minimal3dp/m3dp-changer/m3dp/bom/CxChanger_BOM_6tool.xlsx

Sheet: Summary
CxChanger build cost — Summary
Tools: 6 | Printer: Voron 2.4 350 | Sources: AliExpress + Mouser (see status column)
Section | Cost (USD)
Printhead | $68.44
Maxwell coupling & docks | $31.06
Hotend modules | $222.34
Electronics & power | $126.86
Printed parts | $0.00
Parts subtotal | $448.70
Shipping allowance | $15.00
Sales tax | $43.75
Import fees allowance | $44.87
Contingency | $46.37
ESTIMATED TOTAL | $598.69
Budget | $800.00
Remaining budget | $201.31
Per-tool cost (hotend modules ÷ tools) | $37.06
Not included
Spool holders / filament buffers for 6 separate spools.
Klipper config for T4/T5 (upstream ships T0–T3).
Dock mounting bracket design for the Voron frame (DIY. The project gives the head and basic docks only).
Klipper toolchanger plugin (free software).
Spare nozzles.

Sheet: Assumptions
CxChanger BOM — Assumptions (edit yellow cells)
Assumption | Value | Note / source
Number of tools (hotend modules) | 6 | Docks = tools. Upstream config ships T0–T3. Add T4/T5 macros + extruder4/5 sections.
Use JLC CNC plates? (Y/N) | N | N = print the plates (printed version exists). Y adds the JLCCNC line.
Est. shipping allowance (USD) | $15.00 | Assumption: most AliExpress Choice items ship free over ~$10/seller; allowance covers small-seller shipping.
Sales tax rate | 9.75% | Assumption: Clarksville/Montgomery Co., TN combined rate; AliExpress collects US sales tax at checkout. Verify.
Import fees / duty allowance | 10.00% | Assumption: US de minimis no longer covers China imports; AliExpress usually shows import charges at checkout. Adjust after cart check.
Contingency (wrong parts, re-orders) | 10.00% | Assumption.
Budget (USD) | $800.00 | From Mike's stated toolchanger budget.
How to use
1. Change the tool count in B4 — every per-tool quantity on the BOM tab updates.
2. On the BOM tab, set 'Owned?' to Y for anything you already have; its cost drops to $0.
3. Replace blue 'Est. price' values with the real cart price as you add each item on AliExpress.
4. The Summary tab totals everything against your budget.

Sheet: BOM
CxChanger BOM (v5.5 BOM + v6.11 changes) — 6 tools, Voron 2.4 350
Checked in a browser on aliexpress.us, 2026-09-30, signed out. Totals use the LIST (strikethrough) price, so they are an upper bound. AliExpress showed $1.09 new-shopper deals on most items; your signed-in cart price will likely be lower. Blue = inputs.
# | Section | Part | Spec | Qty needed | Pack size | Packs to buy | List price / pack (USD) | Owned? (Y/N) | Line cost (USD) | Link | Notes | Verification status (2026-09-30) | Promo price shown (new-shopper, signed out)
1 | Printhead | HGX gear set (gears only) | Variant: '1 Set HGX Gear' (17/44 double gear + 36T drive gears) | 1 | 1 | 1 | $6.95 | N | $6.95 | https://www.aliexpress.us/item/3256808936360634.html | MEGA 3D Printer Store, 800+ sold, free shipping. The old link (3256807033585974) was a full extruder with motor ($21.21, $46 express shipping), so it was replaced. | Browser-verified item + variant | $1.09
2 | Printhead | Bearing MR63ZZ 3×6×2.5 mm | 10 pcs/lot | 4 | 10 | 1 | $4.01 | N | $4.01 | https://www.aliexpress.us/item/3256801934742685.html | Homeclub Store, 1,000+ sold. | Browser-verified item | $1.09
3 | Printhead | Dowel pin Ø3 × 16 mm | GB119 listing; pick M3 × 16 | 2 | 20 | 1 | $1.90 | N | $1.90 | https://www.aliexpress.us/item/3256806837028480.html | 304 stainless (not hardened). Variant price not checked. 5,000+ sold. | Browser-verified listing; variant not priced | $1.09
4 | Printhead | Dowel pin Ø3 × 24 mm | GB119 listing; pick M3 × 24 | 1 | 20 | 1 | $1.90 | N | $1.90 | https://www.aliexpress.us/item/3256806837028480.html | Same listing as above. | Browser-verified listing; variant not priced | $1.09
5 | Printhead | Compression spring assortment | Small springs for idler | 1 | 1 | 1 | $3.00 | N | $3.00 | https://www.aliexpress.us/w/wholesale-compression-spring-assortment.html | No listing checked. | Estimate – search link
6 | Printhead | NEMA14 36 mm pancake stepper (HGX-LITE pinion) | 'for HGX-LITE dual gear, 10 teeth reduction gear' | 1 | 1 | 1 | $8.85 | N | $8.85 | https://www.aliexpress.us/item/3256808807952066.html | Pinion must mesh with the HGX 17/44 gear. This listing is sold for HGX-LITE. Alternative: Mellow LDO 36STH20 (item 3256802713546002, $21.37 list / $8.62 shown), but check its pinion. Check your Galileo 2 spare motor first. | Search-page price (item not opened) | $1.09
7 | Printhead | 2510 axial fan 24 V (hotend/throat) | Variant: 24V, hydraulic bearing | 1 | 1 | 1 | $0.87 | N | $0.87 | https://www.aliexpress.us/item/2251832624516972.html | LINK CNC Official Store, 3,000+ sold. | Browser-verified item + variant
8 | Printhead | 4020 blower fan 24 V | Variant: 4020 24V, XH2.54 plug | 1 | 1 | 1 | $3.27 | N | $3.27 | https://www.aliexpress.us/item/2251832787493408.html | IdeaFormer Official Store, 2,000+ sold, free shipping. | Browser-verified item + variant | $1.09
9 | Printhead | Omron D2F-01F micro switch | Variant: D2F-01F, 1 pc | 2 | 1 | 2 | $0.84 | N | $1.68 | https://www.aliexpress.us/item/3256805018062207.html | Qty 2: Z probe + v6.11 tool/filament sensor. Listed 'authentic original'. 5,000+ sold. | Browser-verified item + variant
10 | Printhead | M4 hex standoffs | Pick M4 × 10 (2) and M4 × 14 (1), female-female | 1 | 1 | 1 | $7.58 | N | $7.58 | https://www.aliexpress.us/item/3256808527324482.html | Listing price, variant not checked. | Browser-verified listing; variant not priced | $1.09
11 | Printhead | M4 hollow (through-hole) socket-head bolt | Pick M4, short length | 1 | 1 | 1 | $1.62 | N | $1.62 | https://www.aliexpress.us/item/3256807635919515.html | Original BOM: '带孔螺栓'. | Browser-verified listing; variant not priced | $1.09
12 | Printhead | Metric screw assortment M2 / M2.5 / M3 | SHCS + nuts | 1 | 1 | 1 | $10.00 | N | $10.00 | https://www.aliexpress.us/w/wholesale-m2-m2.5-m3-socket-head-screw-kit.html | No listing checked. Set Owned = Y if you have one. | Estimate – search link
13 | Printhead | M3 × 22 button-head, black 10.9 | Variant: M3 (50pcs), 22mm | 7 | 50 | 1 | $2.44 | N | $2.44 | https://www.aliexpress.us/item/2251832782727837.html | HZYUEGOU. | Browser-verified item + variant | $1.09
14 | Printhead | M3 heat-set inserts | Variant: 100 PCS M3X4X5 | 20 | 100 | 1 | $10.37 | N | $10.37 | https://www.aliexpress.us/item/3256810138806595.html | Check the size against the CAD holes (project lists M3 × 4 × 4). | Browser-verified item + variant | $1.09
15 | Printhead | Self-adhesive high-temp silicone strip 10 × 2 mm | Plugs parked nozzles in the docks | 1 | 1 | 1 | $4.00 | N | $4.00 | https://www.aliexpress.us/w/wholesale-silicone-strip-10x2mm-adhesive.html | No good AliExpress match found (results were door weather-strip). Consider a silicone sheet instead. | Not found – estimate
16 | Printhead | JLC CNC plates (5 parts) | Top magnet plate, spring plate, swing arms ×2, back plate | 0 | 1 | 0 | $22.00 | N | $0.00 | https://jlccnc.com | Not on AliExpress. Controlled by Assumptions B5. | Other vendor – estimate
17 | Maxwell coupling & docks | Dowel pin Ø1.5 × 5 mm | GB119 listing; pick M1.5 × 5 | 6 | 50 | 1 | $1.90 | N | $1.90 | https://www.aliexpress.us/item/3256806837028480.html | Variant price not checked. | Browser-verified listing; variant not priced | $1.09
18 | Maxwell coupling & docks | Round-head pin Ø3 × 4 mm | 3 per hotend | 18 | 20 | 1 | $3.00 | N | $3.00 | https://www.aliexpress.us/w/wholesale-round-head-pin-3mm.html | No match found on AliExpress in 3 searches. Chinese BOM links Tmall item 868817943817. Size 3×4 vs 3×6: check the CAD. | Not found – estimate
19 | Maxwell coupling & docks | Female-threaded round-head pin M3, Ø5 × 20 mm | 1 per dock | 6 | 10 | 1 | $4.00 | N | $4.00 | https://www.aliexpress.us/w/wholesale-m3-internal-thread-round-head-pin-5mm.html | No match found on AliExpress. Chinese BOM links Tmall item 864132087543. | Not found – estimate
20 | Maxwell coupling & docks | N52 magnet Ø6 × 4 mm | Variant: 6x4mm N52, 50pcs | 27 | 50 | 1 | $12.94 | N | $12.94 | https://www.aliexpress.us/item/3256809533301082.html | Magnet Customised Factory Store, 1,000+ sold. 30pcs is $9.65 and 100pcs is $18.49. | Browser-verified item + variant | $1.09
21 | Maxwell coupling & docks | M3 black grade 12.9 socket-head screw (hook) | DIN912; length per CAD | 6 | 50 | 1 | $1.50 | N | $1.50 | https://www.aliexpress.us/item/3256805693063078.html | Listing shows ~$0.02/pc. Must be 12.9 alloy steel so the magnets hold it. | Search-page price (item not opened) | $1.09
22 | Maxwell coupling & docks | Dock cooling fan 2510 24 V, 1 per dock | Same LINK CNC listing, 24V | 6 | 1 | 6 | $0.87 | N | $5.22 | https://www.aliexpress.us/item/2251832624516972.html | Size assumed; verify in the 6.11 dock STEP. | Browser-verified item + variant
23 | Maxwell coupling & docks | M3 roll-in spring T-nuts (2020) | 2 per dock; 50 pcs | 12 | 50 | 1 | $2.50 | N | $2.50 | https://www.aliexpress.us/item/2251832837457300.html | Listing shows ~$0.05/pc. | Search-page price (item not opened) | $1.09
24 | Hotend modules | TZ 2.0 hotend (Bambu X1/P1 style) – Mellow | Variant: 'TZ2 Hotend' | 6 | 1 | 6 | $19.98 | N | $119.88 | https://www.aliexpress.us/item/3256805875155396.html | Mellow 3D Official Store (only 28 sold). The Trianglelab link from the last BOM (1005005920817062) now returns 'page not found' on aliexpress.us. Alternative: YUNSN TZ2.0 kit with 60W heater, item 3256808914626535, 'Hotend for X1' $42.15 list / $33.72 sale. Check whether the Mellow hotend includes a heater. | Browser-verified item + variant | $1.09
25 | Hotend modules | Ceramic heater 24 V 48 W + NTC 100K 3950 | Pick 48W (not 60W/82W) | 6 | 1 | 6 | $3.40 | N | $20.40 | https://www.aliexpress.us/item/3256808485891466.html | Use 48 W: 6 × 82 W = 492 W would overload the 350 W PSU during simultaneous preheat. Set sensor_type to Generic 3950. Upstream uses ATC Semitec 104GT-2. | Search-page price (item not opened) | $2.72
26 | Hotend modules | Silicone sock, Bambu X1/P1 | Variant: For BambuLab X1 P1, 1pcs | 6 | 1 | 6 | $1.79 | N | $10.74 | https://www.aliexpress.us/item/3256808316755061.html | Multi-packs (3/5/10) are available; buying 10 is likely cheaper. | Browser-verified item + variant | $1.09
27 | Hotend modules | Flexible towline cable 4-core 22 AWG | Heater + thermistor, per metre | 9 | 1 | 9 | $3.03 | N | $27.27 | https://www.aliexpress.us/item/2255800968230040.html | Qty in metres. Pick 4-core 22 AWG. Price shown for the default variant. | Search-page price (item not opened) | $2.33
28 | Hotend modules | Molex Micro-Fit 3.0 housings + terminals | 10 sets, 2-pin | 12 | 10 | 2 | $2.03 | N | $4.06 | https://www.aliexpress.us/item/3256802961371687.html | 2 connectors per tool (heater + thermistor). | Search-page price (item not opened) | $1.93
29 | Hotend modules | Capricorn PTFE 1 m (head liner) | Variant: 1M PTFE | 1 | 1 | 1 | $7.69 | N | $7.69 | https://www.aliexpress.us/item/3256804674205585.html | Creality Capricorn. Only the head path needs Capricorn. | Browser-verified item + variant | $1.09
30 | Hotend modules | Generic PTFE 2 × 4 mm (tool feed tubes) | ~1.5 m per tool | 9 | 5 | 2 | $6.00 | N | $12.00 | https://www.aliexpress.us/w/wholesale-ptfe-tube-2x4mm-5m.html | Qty in metres. No listing checked. | Estimate – search link
31 | Hotend modules | PC4-M6 push fittings | Variant: PC4-M6-10pcs | 12 | 10 | 2 | $10.15 | N | $20.30 | https://www.aliexpress.us/item/3256809971210588.html |  | Browser-verified item + variant | $1.09
32 | Electronics & power | Mainboard heater/thermistor ports (T0–T3) | BTT Manta M8P: HE0–HE3 + TH0–TH3 | 1 | 1 | 1 | $0.00 | Y | $0.00 |  | Owned. Covers 4 of 6 tools. | —
33 | Electronics & power | BTT EBB36 CAN V1.2 (T4–T5) | Variant: 'EBB 36' (no MAX31865) | 2 | 1 | 2 | $36.37 | N | $72.74 | https://www.aliexpress.us/item/3256807670809484.html | AliExpress list $36.37 (vs $19.99 at biqu.equipment). Your 2 spare EBB SB2209s do the same job: set Owned = Y. | Browser-verified item + variant | $4.41
34 | Electronics & power | CAN cable (twisted pair + 24 V) | ~2 m | 1 | 1 | 1 | $6.00 | N | $6.00 | https://www.aliexpress.us/w/wholesale-can-bus-cable-4-core-twisted.html | No good AliExpress match found. | Not found – estimate
35 | Electronics & power | Mean Well LRS-350-24 (24 V 14.6 A, 350 W) | Dedicated hotend PSU | 1 | 1 | 1 | $32.10 | N | $32.10 | https://www.mouser.com/ProductDetail/MEAN-WELL/LRS-350-24?qs=ah3jBNVE1PT%2BkwLcackrGA%3D%3D | Mouser $32.10 (TRC $34.81). From an authorized distributor, not AliExpress. | Authorized distributor – price verified
36 | Electronics & power | Ferrule crimper + ferrule kit | For PSU AC/DC wiring | 1 | 1 | 1 | $16.02 | N | $16.02 | https://www.aliexpress.us/item/3256809851025256.html | Skip if you have a crimper. Common DC − between the PSUs; earth both chassis. | Search-page price (item not opened) | $1.09
37 | Electronics & power | Nozzle offset calibration probe | BTT Eddy (owned) or ball probe | 1 | 1 | 1 | $0.00 | Y | $0.00 |  | Owned. | —
38 | Printed parts | Printed parts filament (ABS/ASA) | ~0.6 kg | 1 | 1 | 1 | $15.00 | Y | $0.00 | https://www.aliexpress.us/w/wholesale-asa-filament-1kg.html | Assumed owned. | —
 |  |  |  |  |  |  |  | Total | $448.70

Sheet: Sources
Sources
CxChanger original repo + 5.5 BOM (quantities, ¥ prices) | https://github.com/cx330-TXY/CxChanger
CxChanger English translation (parts list, pin sizes) | https://github.com/WheelsTheCat/CxChanger
Trianglelab TZ-V6-2.0 hotend list price ($27) | https://www.trianglelab.net/products/tz-v6-20-hotend
AliExpress TZ 2.0 hotend listing | https://www.aliexpress.com/item/1005005920817062.html
AliExpress ceramic heater + thermistor listing | https://www.aliexpress.us/item/3256807569217043.html
AliExpress 36 mm pancake stepper listing | https://www.aliexpress.us/item/3256804107613674.html
AliExpress HGX gear set listing | https://www.aliexpress.us/item/3256807033585974.html
Mouser LRS-350-24 ($32.10, verified 2026-09-30) | https://www.mouser.com/ProductDetail/MEAN-WELL/LRS-350-24?qs=ah3jBNVE1PT%2BkwLcackrGA%3D%3D
TRC Electronics LRS-350-24 ($34.81) | https://www.trcelectronics.com/products/mean-well-lrs-350-24
Trianglelab TZ 2.0 for Bambu ($45.99) | https://trianglelab.net/products/tz-20-hotend-for-bambu-lab-x1-p1p
BIQU EBB36/42 (from $19.99) | https://biqu.equipment/products/bigtreetech-ebb36-42-can-bus-u2c-v2-1-klipper-board
AliExpress EBB36 CAN V1.2 listing | https://www.aliexpress.us/item/3256804056891440.html
Upstream v6.11 changes (2026-09-29): new printhead 6.11 zip, dock 6.11 STEP, tool-change-failure + runout sensor | https://github.com/cx330-TXY/CxChanger/commits/main
Note: AliExpress blocks automated reads. AliExpress prices are estimates; verify in cart.
