minimal3dp/m3dp-changer/m3dp/cad/printed-6.11/voron-integration/tap/tap-adapter-top-fan-carrier-PROTOTYPE-assembly.stl

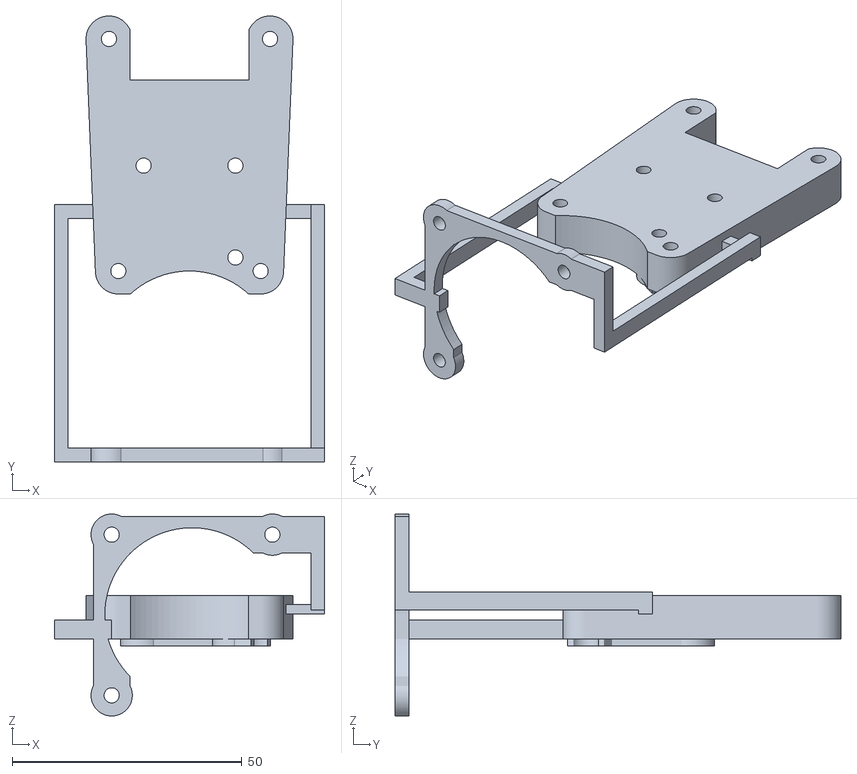
[picture p2: CAD file, 2026-11-01]
m3dp/cad/printed-6.11/voron-integration/tap/tap-adapter-top-fan-carrier-PROTOTYPE-assembly.stl
58.9 x 97.1 x 44.0
