minimal3dp/m3dp-changer/m3dp/cad/printed-6.11/p1-magnet-plate-integral-pillars-assembly.stl

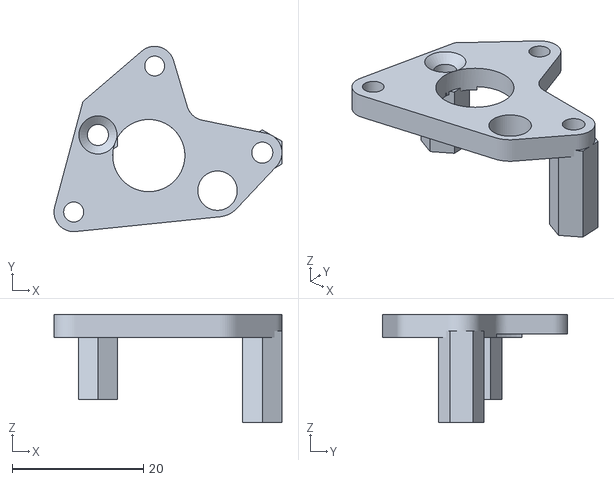
[picture p3: CAD file, 2026-11-01]
m3dp/cad/printed-6.11/p1-magnet-plate-integral-pillars-assembly.stl
34.8 x 28.2 x 16.5
