minimal3dp/m3dp-changer/m3dp/cad/printed-6.11/voron-integration/tap/tap-top-fan-duct-PROTOTYPE-assembly.stl

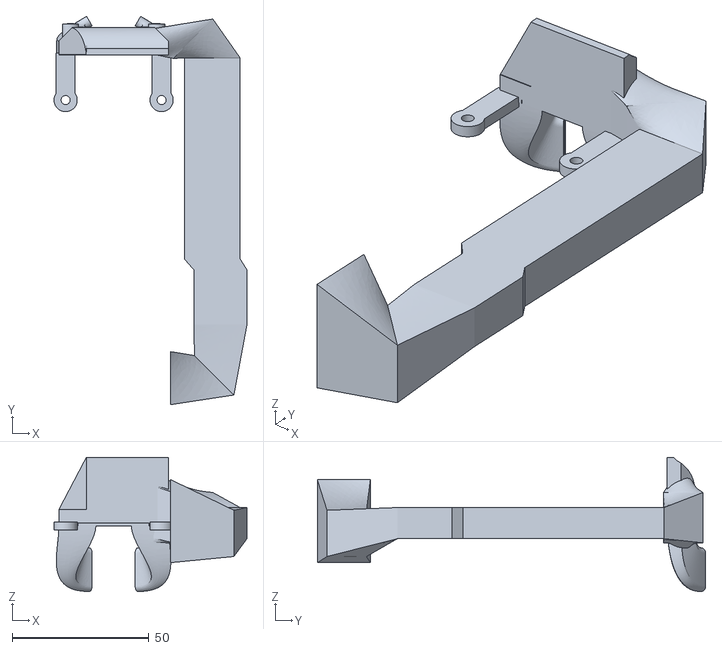
[picture p4: CAD file, 2026-11-01]
m3dp/cad/printed-6.11/voron-integration/tap/tap-top-fan-duct-PROTOTYPE-assembly.stl
70.5 x 142.0 x 49.0
