minimal3dp/m3dp-changer/m3dp/cad/printed-6.11/p3-cover-left-clamp-web-assembly.stl

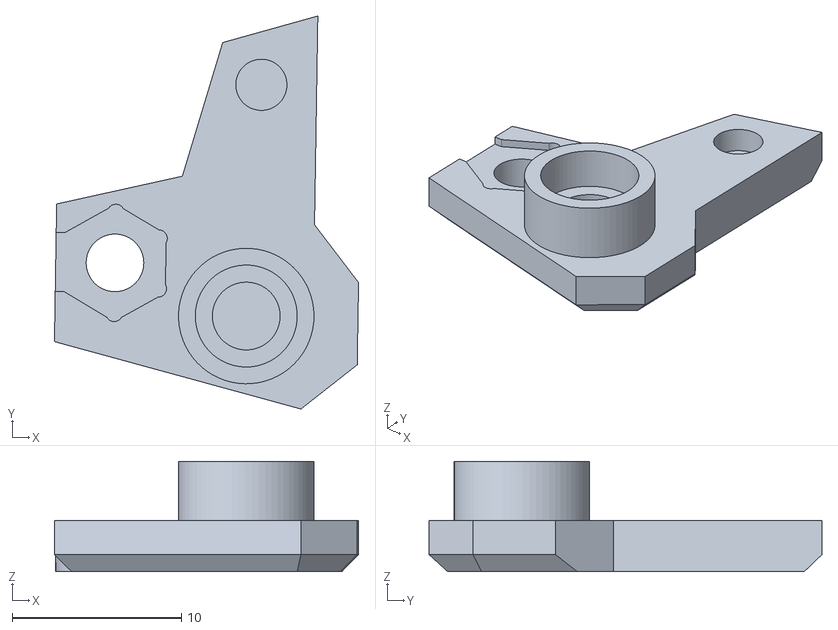
[picture p5: CAD file, 2026-11-01]
m3dp/cad/printed-6.11/p3-cover-left-clamp-web-assembly.stl
18.0 x 23.2 x 6.50
