minimal3dp/m3dp-changer/m3dp/cad/printed-6.11/p4-cover-right-clamp-web-assembly.stl

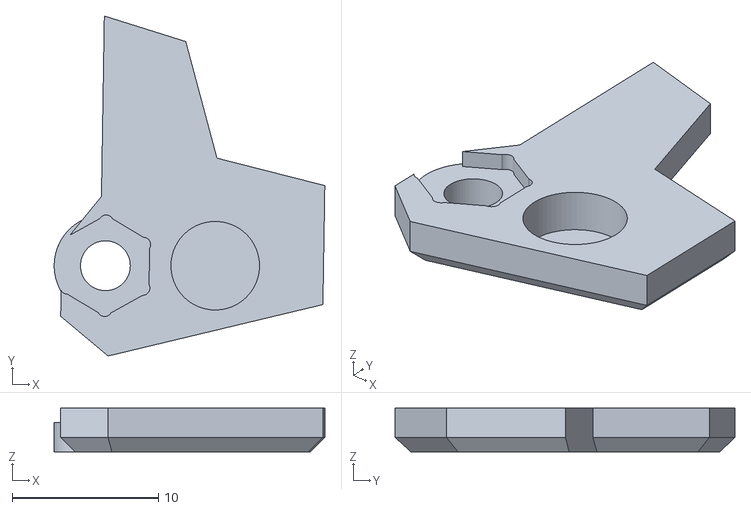
[picture p6: CAD file, 2026-11-01]
m3dp/cad/printed-6.11/p4-cover-right-clamp-web-assembly.stl
18.5 x 23.2 x 3.00
