minimal3dp/m3dp-changer/m3dp/cad/m3dp_cnc_6_p7.step

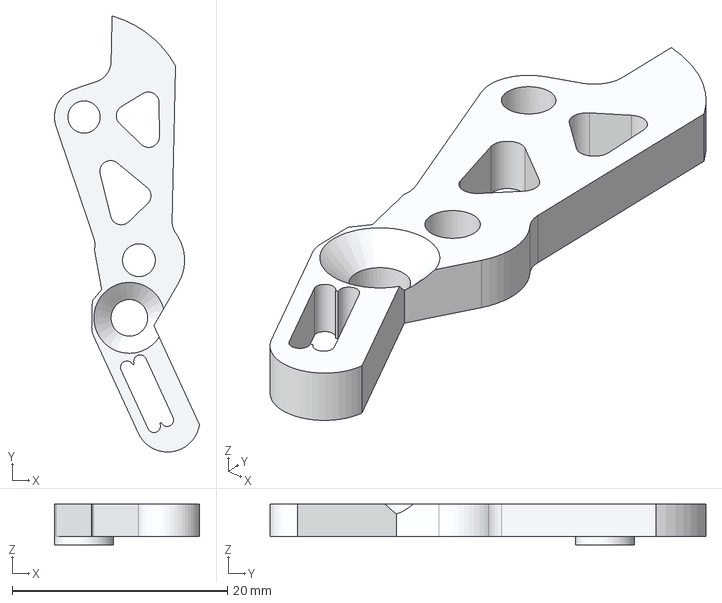
[picture p7: CAD file, 2026-11-01]
m3dp/cad/m3dp_cnc_6_p7.step
13.5 x 40.5 x 3.80 mm
