minimal3dp/m3dp-changer/m3dp/cad/printed-6.11/unchanged-printables/hotend-holder-print-position.step

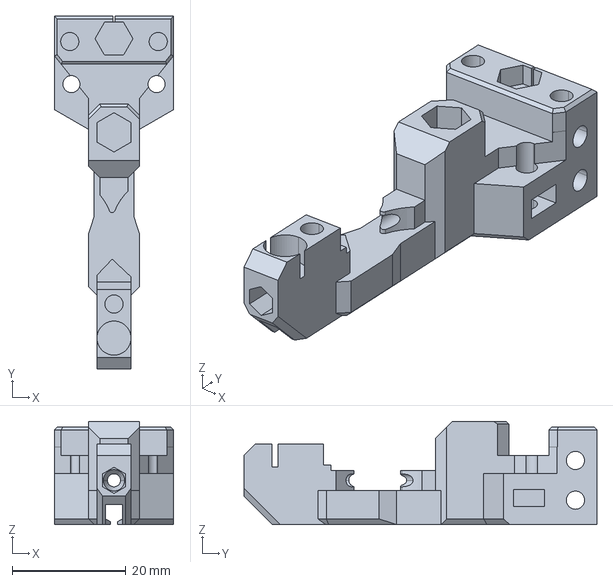
[picture p8: CAD file, 2026-11-01]
m3dp/cad/printed-6.11/unchanged-printables/hotend-holder-print-position.step
21.0 x 62.2 x 18.2 mm
