minimal3dp/m3dp-changer/m3dp/cad/printed-6.11/unchanged-printables/source/p2-spring-support-plate.step

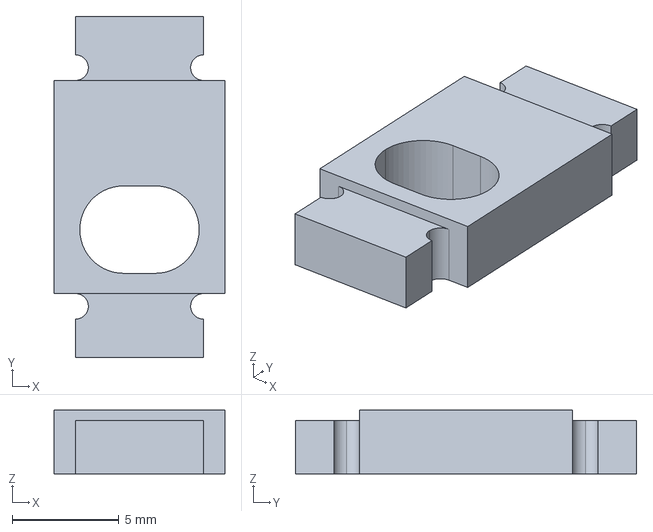
[picture p9: CAD file, 2026-11-01]
m3dp/cad/printed-6.11/unchanged-printables/source/p2-spring-support-plate.step
8.00 x 16.0 x 3.00 mm
