minimal3dp/m3dp-changer/m3dp/cad/printed-6.11/voron-integration/detector/source/upstream-611-upper-detector-mount.step

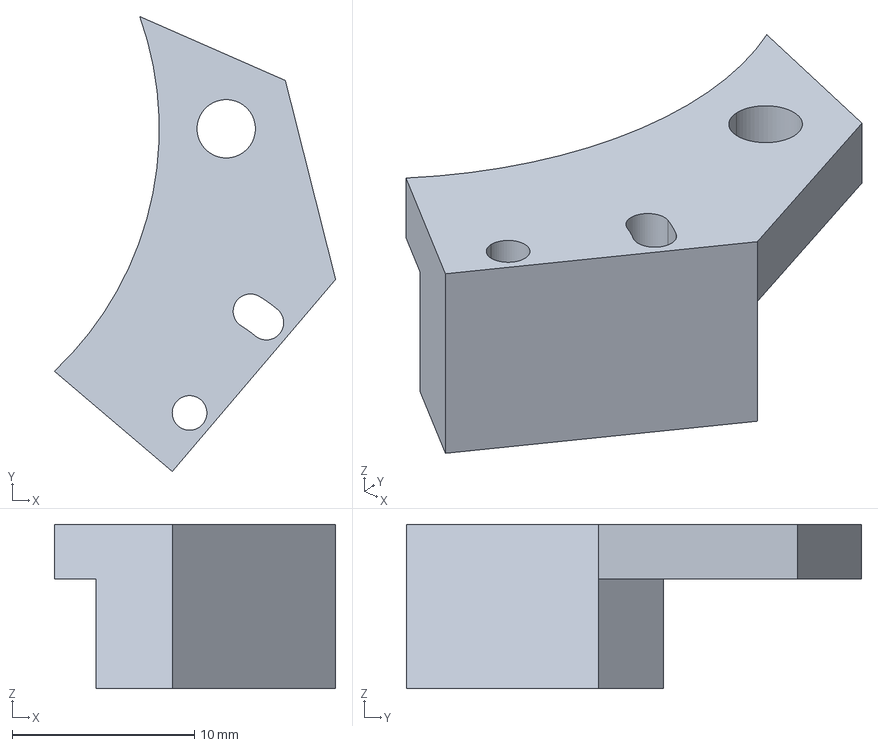
[picture p10: CAD file, 2026-11-01]
m3dp/cad/printed-6.11/voron-integration/detector/source/upstream-611-upper-detector-mount.step
15.4 x 25.0 x 9.00 mm
