minimal3dp/m3dp-changer/m3dp/cad/printed-6.11/voron-integration/dock/build123d/2510-cage-fit-coupon-build123d-4p6.step

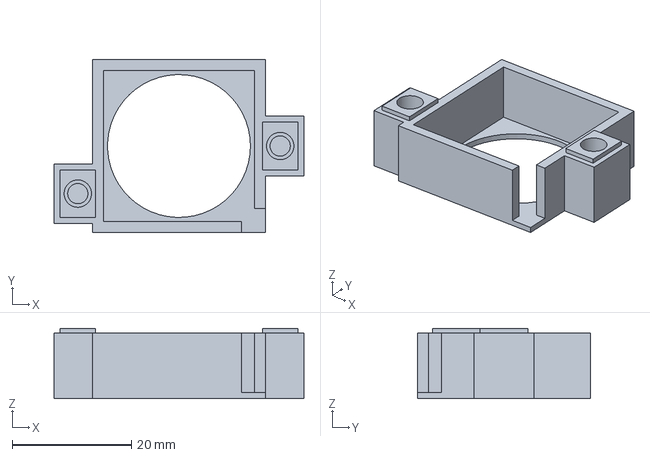
[picture p12: CAD file, 2026-11-01]
m3dp/cad/printed-6.11/voron-integration/dock/build123d/2510-cage-fit-coupon-build123d-4p6.step
42.0 x 29.0 x 11.8 mm
