minimal3dp/m3dp-changer/m3dp/cad/printed-6.11/voron-integration/dock/fan-retainer-left.step

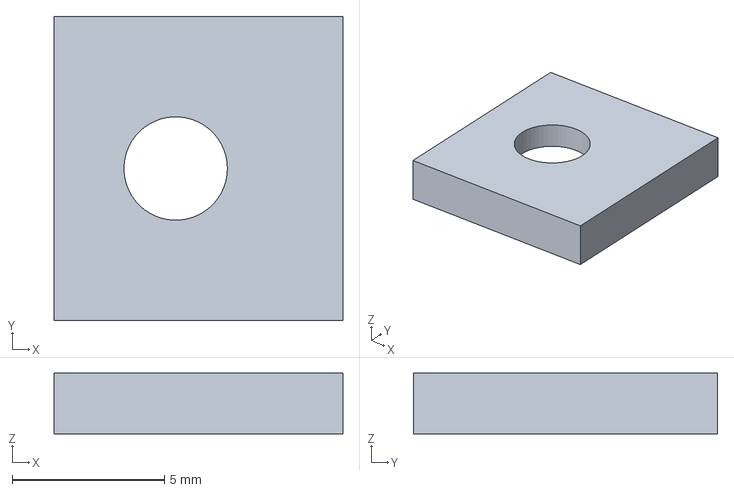
[picture p13: CAD file, 2026-11-01]
m3dp/cad/printed-6.11/voron-integration/dock/fan-retainer-left.step
9.50 x 10.0 x 2.00 mm
