minimal3dp/m3dp-changer/m3dp/cad/printed-6.11/voron-integration/rail/front-rail-support-left.step

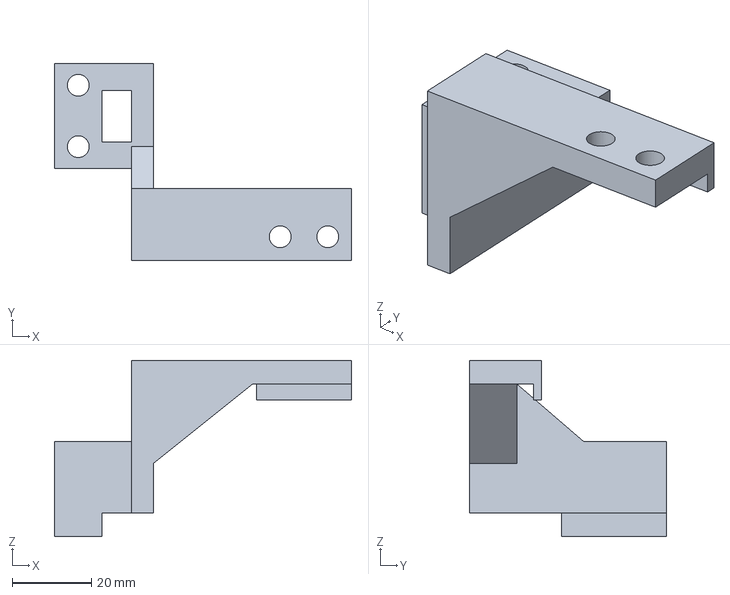
[picture p14: CAD file, 2026-11-01]
m3dp/cad/printed-6.11/voron-integration/rail/front-rail-support-left.step
75.0 x 49.8 x 44.5 mm
