minimal3dp/m3dp-changer/m3dp/cad/printed-6.11/voron-integration/tap/source/cx/original-4020-duct.step

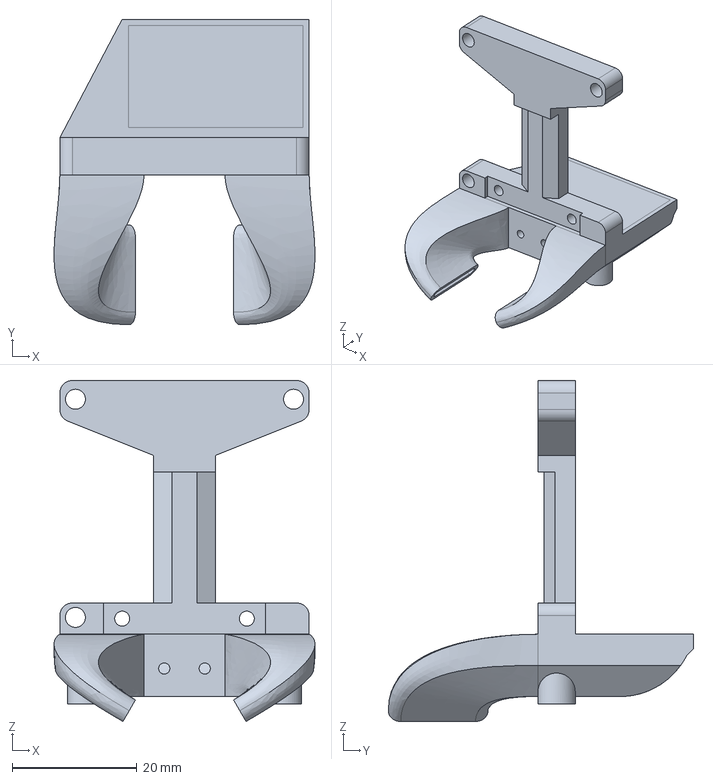
[picture p15: CAD file, 2026-11-01]
m3dp/cad/printed-6.11/voron-integration/tap/source/cx/original-4020-duct.step
41.9 x 49.0 x 54.7 mm
