minimal3dp/m3dp-changer/stl/coupons/insert-coupon-4p6.stl

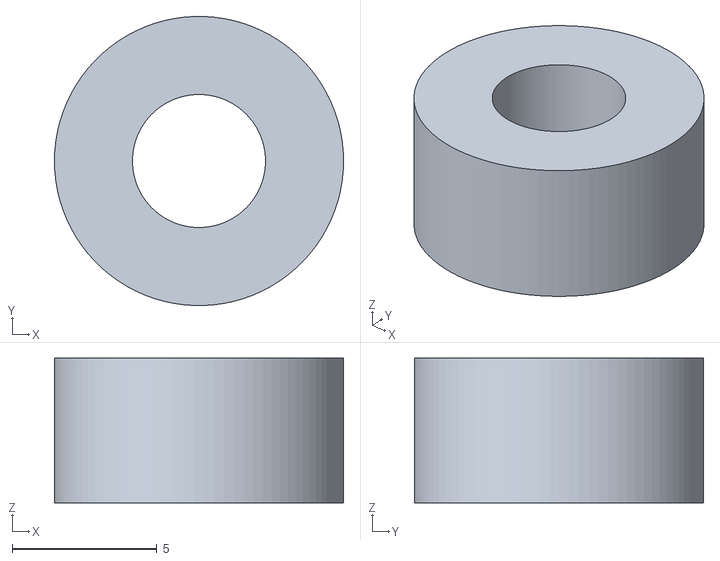
[picture p16: CAD file, 2026-11-01]
stl/coupons/insert-coupon-4p6.stl
10.0 x 9.99 x 5.00
