minimal3dp/m3dp-changer/m3dp/cad/m3dp_cnc_6_p5.step

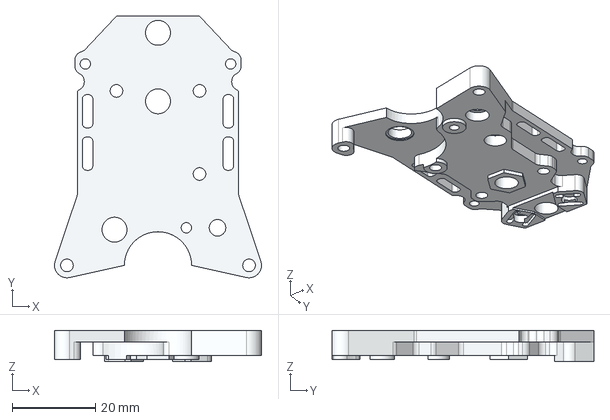
[picture p17: CAD file, 2026-11-01]
m3dp/cad/m3dp_cnc_6_p5.step
49.8 x 63.0 x 7.50 mm
