minimal3dp/m3dp-changer/m3dp/cad/printed-6.11/source/m3dp_cnc_6_p1.step

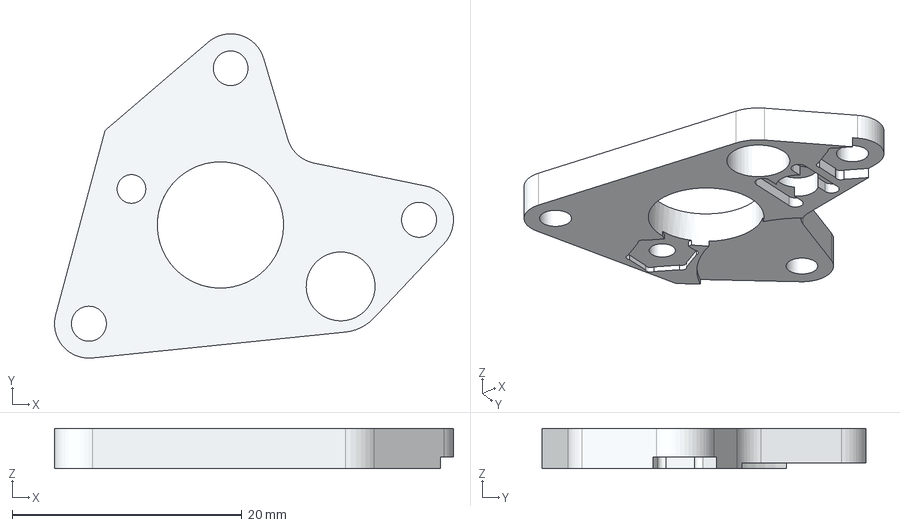
[picture p18: CAD file, 2026-11-01]
m3dp/cad/printed-6.11/source/m3dp_cnc_6_p1.step
34.8 x 28.2 x 3.50 mm
