minimal3dp/m3dp-changer/m3dp/cad/printed-6.11/voron-integration/rail/front-gantry-fit-coupon.step

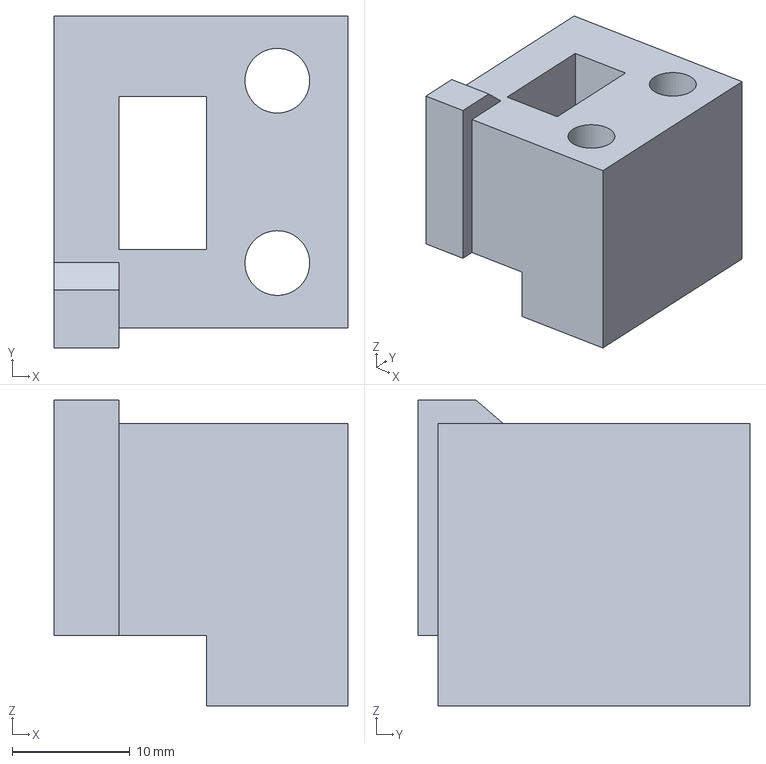
[picture p19: CAD file, 2026-11-01]
m3dp/cad/printed-6.11/voron-integration/rail/front-gantry-fit-coupon.step
25.0 x 28.2 x 26.0 mm
