minimal3dp/m3dp-changer/stl/coupons/raised-2020-saddle-fit-coupon.stl

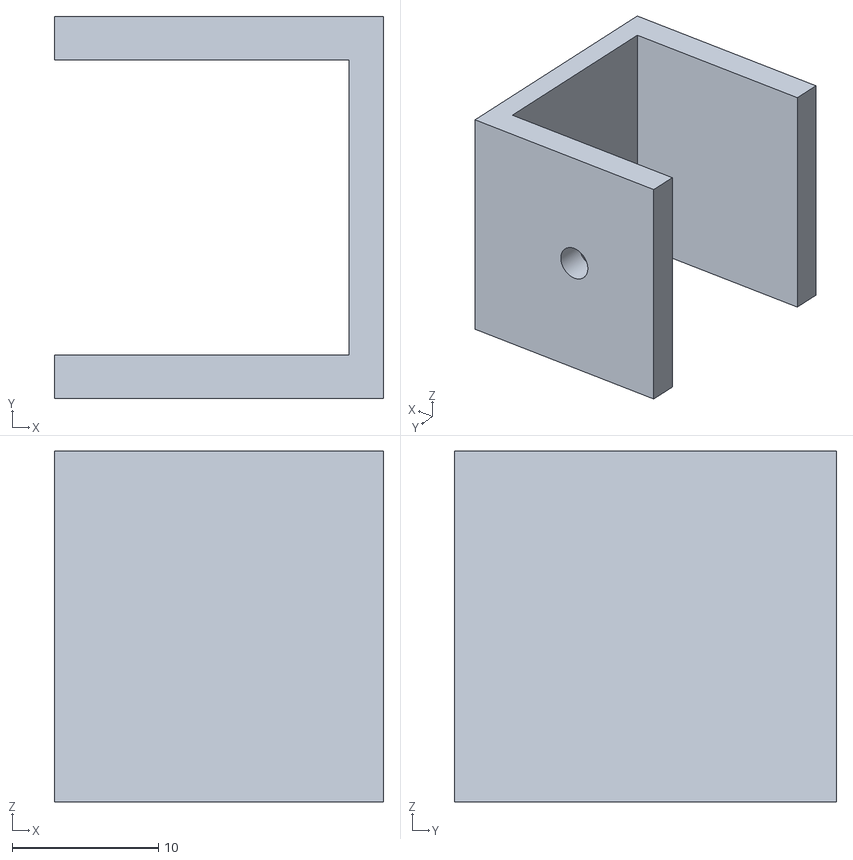
[picture p20: CAD file, 2026-11-01]
stl/coupons/raised-2020-saddle-fit-coupon.stl
22.5 x 26.1 x 24.0
