minimal3dp/m3dp-changer/m3dp/cad/m3dp_cnc_6.11.step

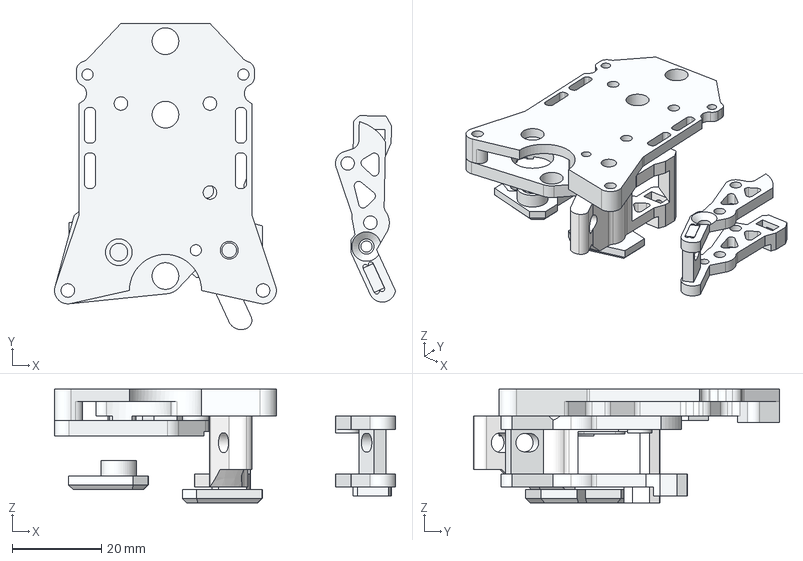
[picture p21: CAD file, 2026-11-01]
m3dp/cad/m3dp_cnc_6.11.step
76.6 x 68.8 x 25.5 mm
顶部磁铁固定板
弹簧撑板
简化盖板_简化盖板左
简化盖板_简化盖板右
打印头背板cnc（三叉戟）
摆杆外带轴承（CNC）
摆杆外带轴承（CNC）_摆杆内
带轴承摆臂打印一体式
