minimal3dp/m3dp-changer/m3dp/cad/printed-6.11/source/dock-6.11-EN.STEP

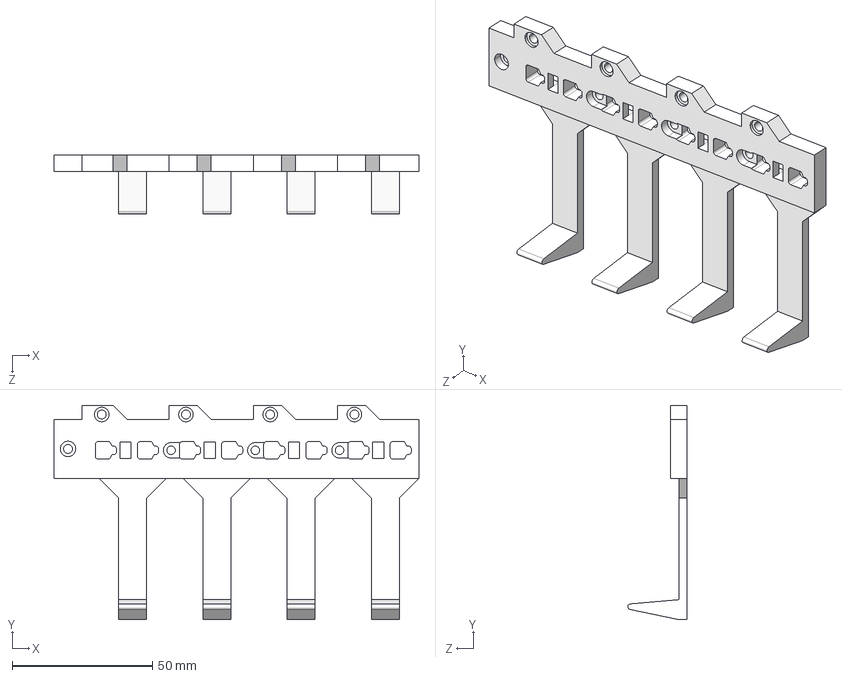
[picture p22: CAD file, 2026-11-01]
m3dp/cad/printed-6.11/source/dock-6.11-EN.STEP
130.0 x 76.3 x 21.2 mm
