minimal3dp/m3dp-changer/m3dp/cad/printed-6.11/unchanged-printables/p8-printed-bearing-arm-print-position.step

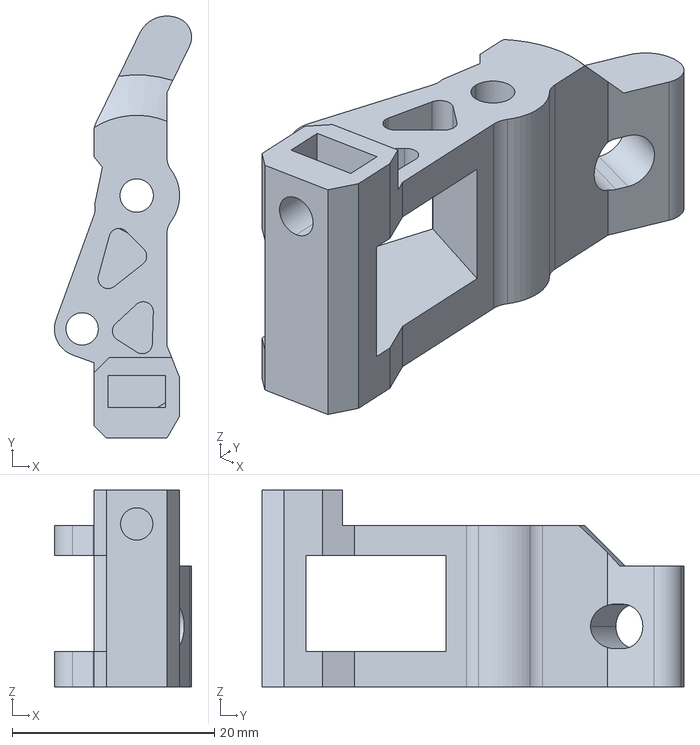
[picture p23: CAD file, 2026-11-01]
m3dp/cad/printed-6.11/unchanged-printables/p8-printed-bearing-arm-print-position.step
13.6 x 41.8 x 19.5 mm
