minimal3dp/m3dp-changer/m3dp/cad/printed-6.11/voron-integration/dock/fan-retainer-middle.step

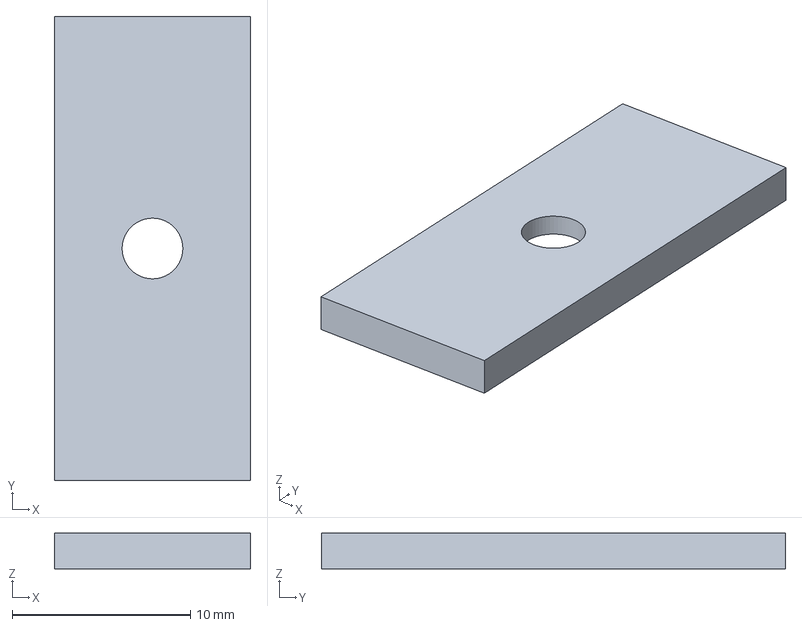
[picture p24: CAD file, 2026-11-01]
m3dp/cad/printed-6.11/voron-integration/dock/fan-retainer-middle.step
11.0 x 26.0 x 2.00 mm
