minimal3dp/m3dp-changer/m3dp/cad/m3dp_cnc_6_p4.step

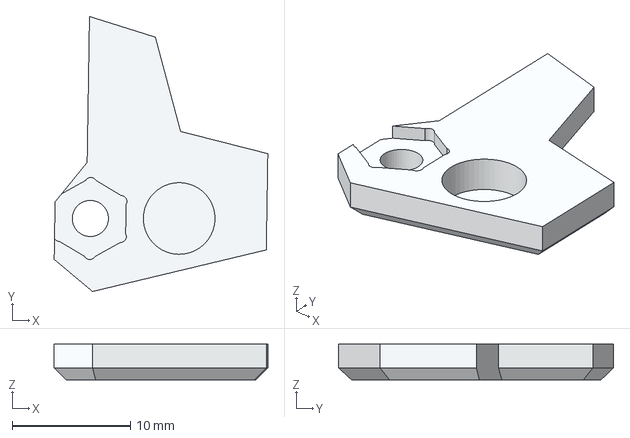
[picture p26: CAD file, 2026-11-01]
m3dp/cad/m3dp_cnc_6_p4.step
18.0 x 23.2 x 3.00 mm
