minimal3dp/m3dp-changer/m3dp/cad/printed-6.11/unchanged-printables/unchanged-printables-6.11.FCStd

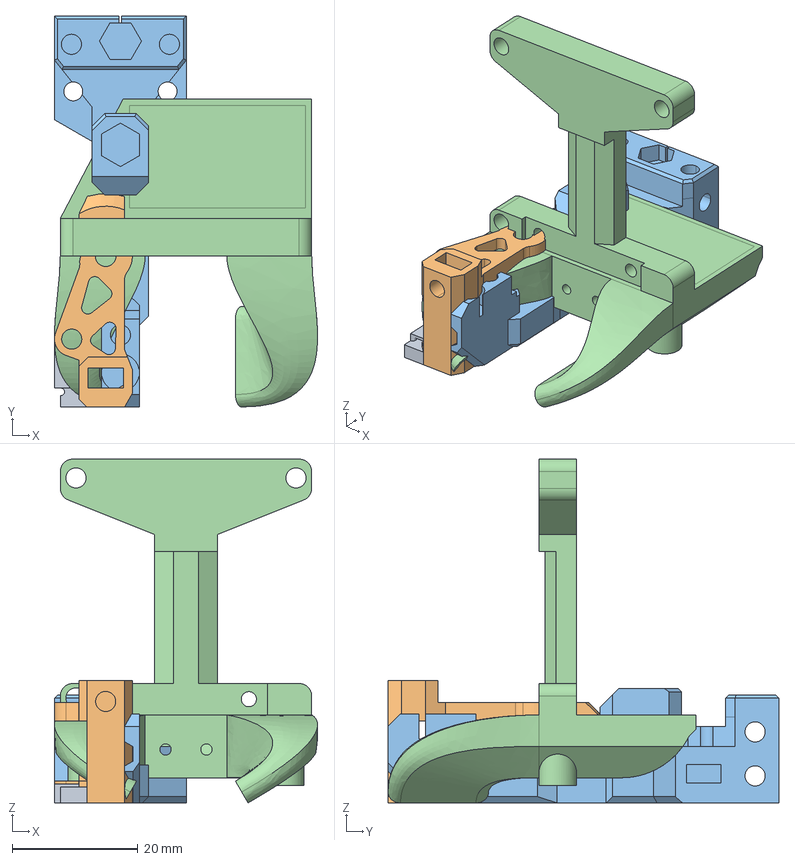
[picture p27: CAD file, 2026-11-01]
m3dp/cad/printed-6.11/unchanged-printables/unchanged-printables-6.11.FCStd
41.9 x 62.2 x 54.7 mm
p2-spring-support-plate
p8-printed-bearing-arm
hotend-holder
4020-part-cooling-duct
