minimal3dp/m3dp-changer/stl/reference-only/two-station-dock.stl

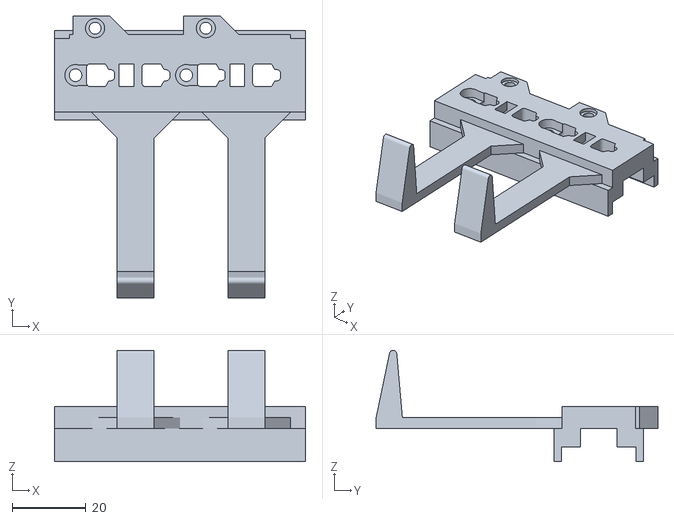
[picture p28: CAD file, 2026-11-01]
stl/reference-only/two-station-dock.stl
68.0 x 76.3 x 30.2
