minimal3dp/m3dp-changer/m3dp/cad/printed-6.11/voron-integration/dock/two-station-raised-rail-dock-prototype-print.stl

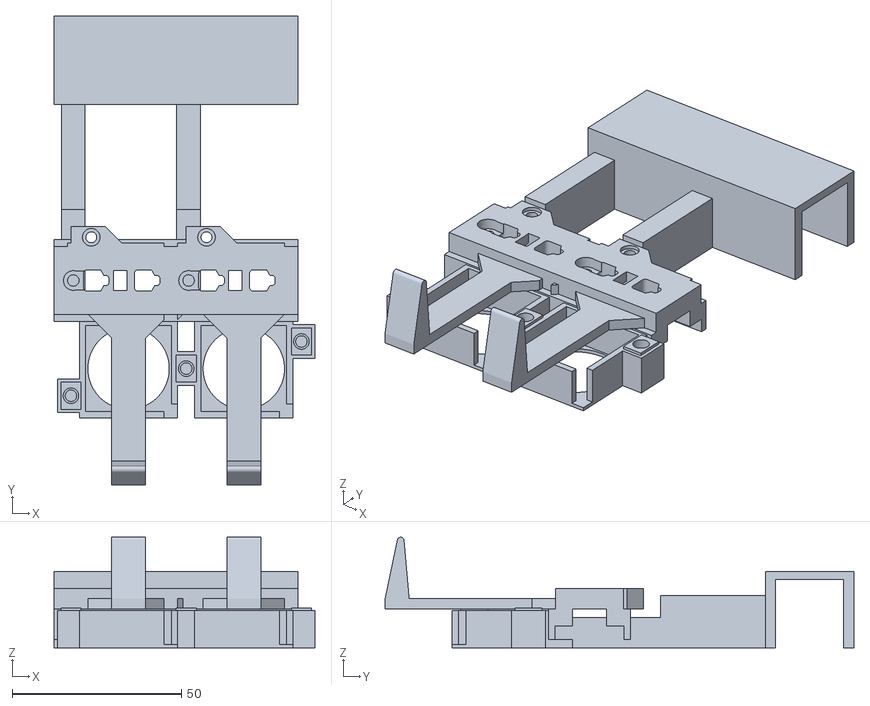
[picture p29: CAD file, 2026-11-01]
m3dp/cad/printed-6.11/voron-integration/dock/two-station-raised-rail-dock-prototype-print.stl
77.0 x 138.3 x 32.7
