minimal3dp/m3dp-changer/m3dp/cad/printed-6.11/voron-integration/tap/CxChangerTopTapPrototype.FCStd

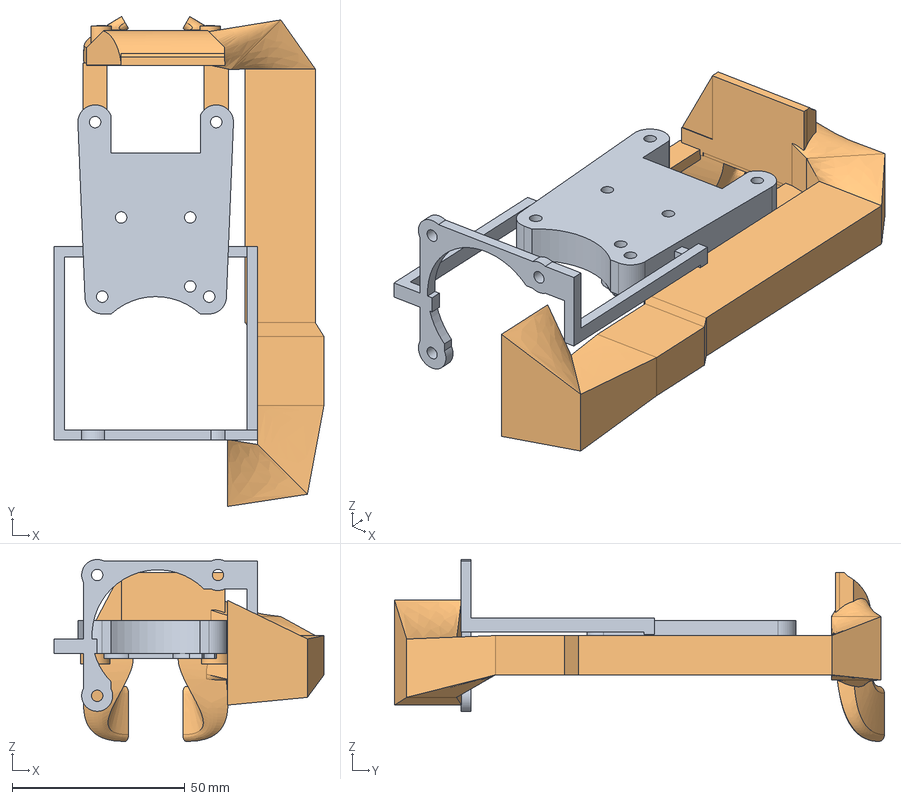
[picture p30: CAD file, 2026-11-01]
m3dp/cad/printed-6.11/voron-integration/tap/CxChangerTopTapPrototype.FCStd
78.2 x 141.9 x 52.8 mm
TAP adapter and top-fan carrier — PROTOTYPE
Top-fan side-feed duct — PROTOTYPE
