minimal3dp/m3dp-changer/m3dp/cad/printed-6.11/insert-fit-coupon.step

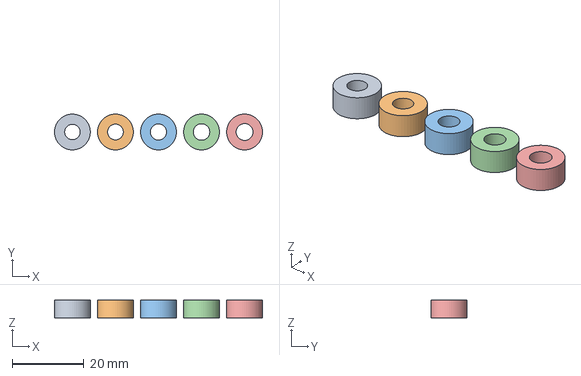
[picture p31: CAD file, 2026-11-01]
m3dp/cad/printed-6.11/insert-fit-coupon.step
58.0 x 10.00 x 5.00 mm
