minimal3dp/m3dp-changer/m3dp/cad/printed-6.11/voron-integration/tap/chaoticlab-v2-interface-fit-gauge.step

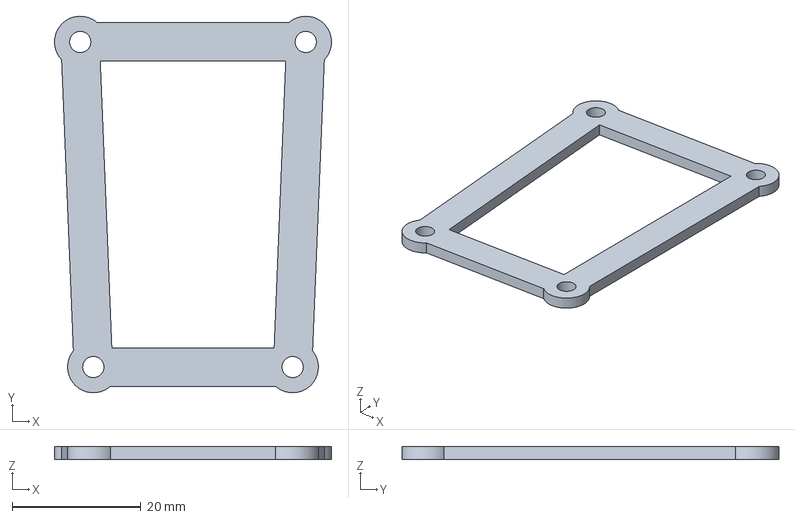
[picture p32: CAD file, 2026-11-01]
m3dp/cad/printed-6.11/voron-integration/tap/chaoticlab-v2-interface-fit-gauge.step
43.1 x 58.6 x 2.00 mm
