minimal3dp/m3dp-changer/m3dp/cad/printhead-6.11-corrected-EN.STEP

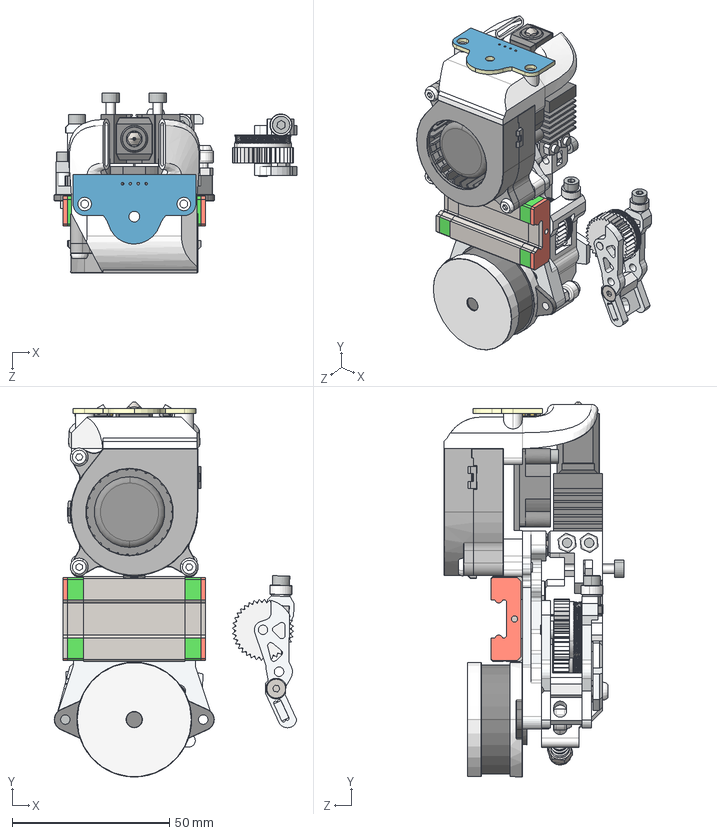
[picture p33: CAD file, 2026-11-01]
m3dp/cad/printhead-6.11-corrected-EN.STEP
77.1 x 119.2 x 57.4 mm
HGX gear 17T-44T double (compound) gear
36T extruder drive gear x 3
Dowel pin D3 x 16 x 2
Dowel pin OD1.5 x L5 x 6
Bearing OD6 ID3 W2.5 (MR63ZZ) x 3
N52 magnet 6x4mm x 6
NEMA14 36mm pancake stepper
2510 fan
Hotend holder
Heatsink (Bambu Lab style)
Nozzle + heatbreak (Bambu Lab style)
Bambu P1P ceramic heater
Silicone sock
Socket head cap screw M3x10 DIN912 x 2
Filament (reference body)
Round head pin OD3 x L4 x 3
M3 hex nut x 7
Socket head cap screw M3x22 DIN912 x 2
M4 hollow through-hole bolt
Compression spring
M4 anti-loosening lock nut
Top magnet retaining plate
Spring support plate
Socket head cap screw M3x15 DIN912 x 2
Socket head cap screw M2.5x14 DIN912 x 2
Dowel pin D3 x 24
M4 hex standoff 10mm x 2
M4 hex standoff 14mm
Simplified cover_left
Simplified cover_right
4020 blower fan_Default
Button head screw M3x22 ISO7380 x 4
Printhead back plate CNC (Trident)
MGN12H
Swing lever outer with bearing (CNC)
Bearing 3x7x3 (683ZZ) x 2
Swing lever outer with bearing (CNC)_inner lever
Socket head cap screw M3x8 DIN912 x 2
Washer 3.2x6x0.5 x 2
Countersunk screw M3x16 DIN7991
Swing arm with bearing - printed one-piece version
Eddy current leveling probe
Part cooling duct (modified)
Button head screw M3x16 ISO7380
