minimal3dp/m3dp-changer/m3dp/cad/m3dp_cnc_6_p6.step

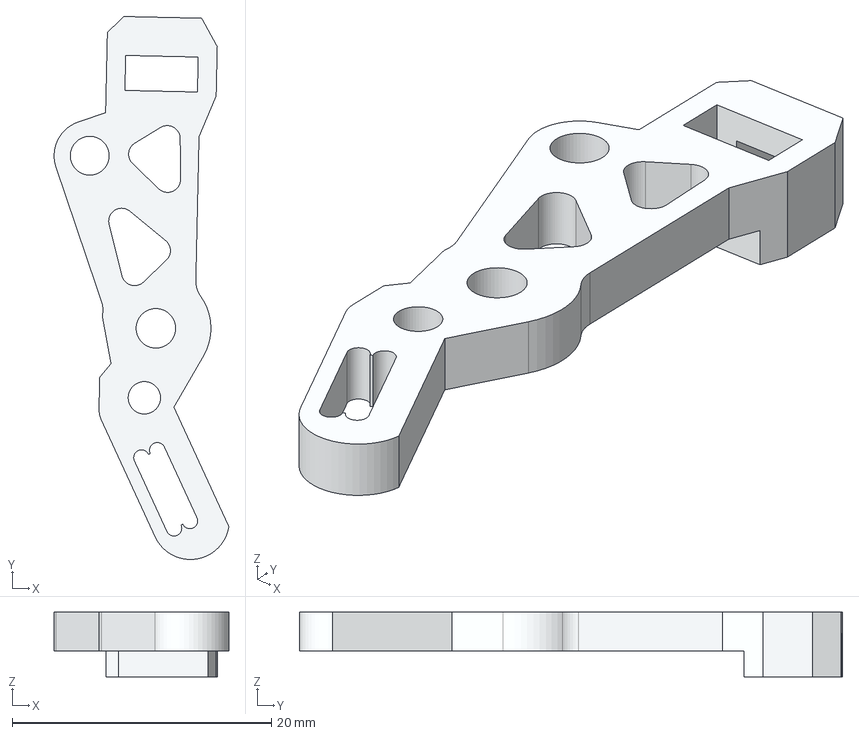
[picture p34: CAD file, 2026-11-01]
m3dp/cad/m3dp_cnc_6_p6.step
13.5 x 41.9 x 5.00 mm
