minimal3dp/m3dp-changer/m3dp/cad/m3dp_cnc_6_p8.step

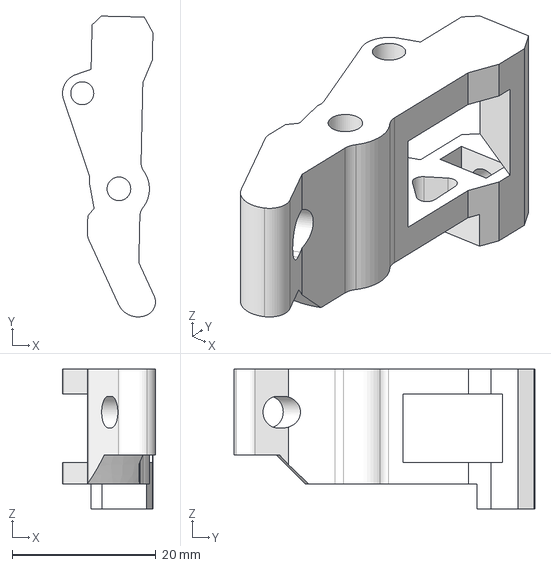
[picture p35: CAD file, 2026-11-01]
m3dp/cad/m3dp_cnc_6_p8.step
12.9 x 41.9 x 19.5 mm
