minimal3dp/m3dp-changer/m3dp/cad/printed-6.11/CxChanger6_11IntegralPillars.FCStd

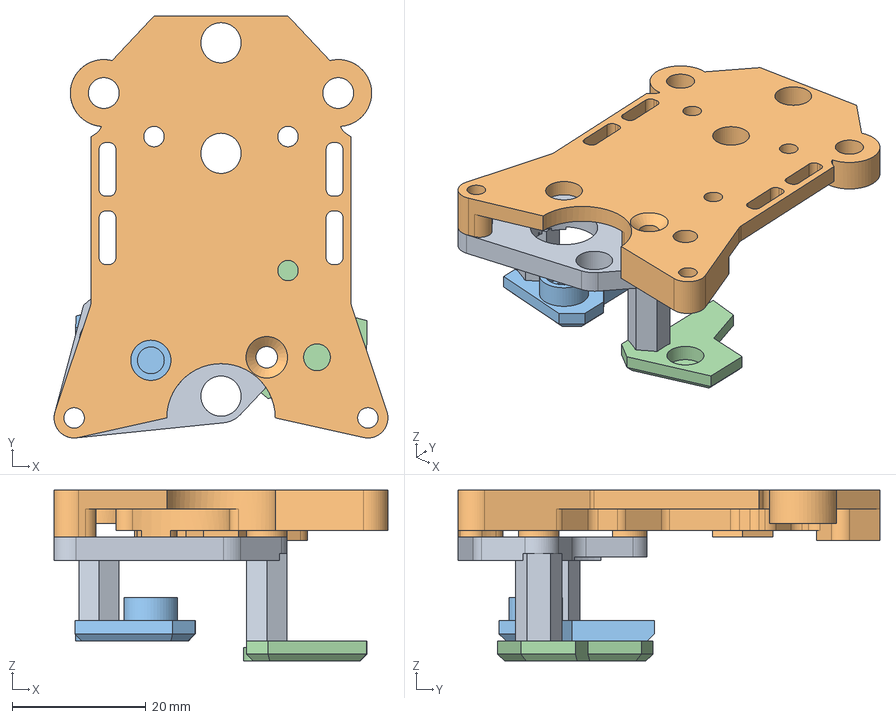
[picture p36: CAD file, 2026-11-01]
m3dp/cad/printed-6.11/CxChanger6_11IntegralPillars.FCStd
49.8 x 63.0 x 25.5 mm
P1 — integral 10 mm and 14 mm pillars; through-bolts only
P5 — two front inserts; rear through-bolt into lower nut
P3 — reinforced washer seat and3.4mm through-hole
P4 — reinforced washer seat and3.4mm through-hole
