minimal3dp/m3dp-changer/m3dp/cad/m3dp_cnc_6_p2.step

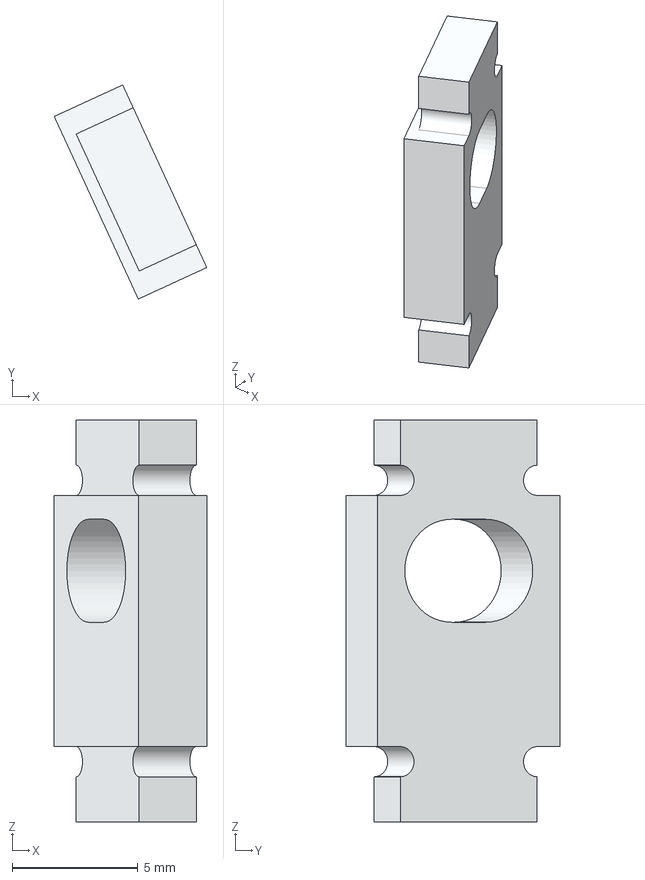
[picture p37: CAD file, 2026-11-01]
m3dp/cad/m3dp_cnc_6_p2.step
6.07 x 8.52 x 16.0 mm
