minimal3dp/m3dp-changer/(list of files, cad)

Other CAD files:
m3dp/cad/printed-6.11/p4-cover-right-clamp-web-print-flat.stl
m3dp/cad/printed-6.11/source/m3dp_cnc_6_p3.step
m3dp/cad/printed-6.11/voron-integration/tap/tap-top-fan-duct-PROTOTYPE-print-with-external-supports.stl
stl/fan-retainer-left.stl
m3dp/cad/printed-6.11/p4-cover-right-clamp-web.step
m3dp/cad/printed-6.11/unchanged-printables/p2-spring-support-plate-print-position.step
m3dp/cad/printed-6.11/unchanged-printables/source/hotend-holder.step
m3dp/cad/printed-6.11/voron-integration/dock/fan-retainer-right-print.stl
m3dp/cad/printed-6.11/voron-integration/tap/tap-adapter-top-fan-carrier-PROTOTYPE.step
stl/fan-retainer-right.stl
stl/reference-only/p2-spring-support-plate.stl
m3dp/cad/printed-6.11/p3-cover-left-clamp-web.step
m3dp/cad/printed-6.11/unchanged-printables/source/p8-printed-bearing-arm.step
stl/coupons/insert-coupon-4p5.stl
stl/front-rail-support-right.stl
stl/reference-only/4020-part-cooling-duct.stl
m3dp/cad/printed-6.11/voron-integration/dock/2510-cage-fit-coupon-print.stl
m3dp/cad/printed-6.11/voron-integration/tap/tap-adapter-top-fan-carrier-PROTOTYPE-print-with-external-supports.stl
stl/coupons/insert-coupon-4p4.stl
stl/tool-detector-mount-PROTOTYPE.stl
m3dp/cad/printed-6.11/p3-cover-left-clamp-web-print-flat.stl
m3dp/cad/printed-6.11/unchanged-printables/4020-part-cooling-duct-print-position.step
stl/coupons/insert-coupon-4p3.stl
stl/hotend-holder.stl
m3dp/cad/printed-6.11/voron-integration/dock/fan-retainer-middle-print.stl
stl/coupons/insert-coupon-4p7.stl
m3dp/cad/printed-6.11/p1-magnet-plate-integral-pillars-print-flat.stl
m3dp/cad/printed-6.11/voron-integration/dock/raised-2020-saddle-fit-coupon.step
m3dp/cad/printed-6.11/voron-integration/tap/ChaoticlabV2InterfaceGauge.FCStd
stl/coupons/2510-cage-fit-coupon.stl
stl/tap-top-fan-duct-PROTOTYPE.stl
m3dp/cad/m3dp_cnc_6_p3.step
m3dp/cad/printed-6.11/insert-coupon-4p6.step
m3dp/cad/printed-6.11/voron-integration/dock/two-station-raised-rail-dock-prototype.step
stl/coupons/front-gantry-fit-coupon.stl
stl/front-rail-support-left.stl
m3dp/cad/printed-6.11/voron-integration/dock/fan-retainer-right.step
m3dp/cad/printed-6.11/voron-integration/tap/tap-top-fan-duct-PROTOTYPE.step
stl/coupons/chaoticlab-v2-interface-fit-gauge.stl
stl/p4-cover-right-clamp-web-print-flat.stl
stl/p1-magnet-plate-integral-pillars-print-flat.stl
m3dp/cad/printed-6.11/voron-integration/dock/2510-cage-fit-coupon.step
stl/p3-cover-left-clamp-web-print-flat.stl
m3dp/cad/printed-6.11/insert-coupon-4p4.step
m3dp/cad/printed-6.11/voron-integration/dock/fan-retainer-left-print.stl
stl/tap-adapter-top-fan-carrier-PROTOTYPE.stl
m3dp/cad/printed-6.11/insert-coupon-4p7.step
stl/fan-retainer-middle.stl
stl/p8-printed-bearing-arm.stl
m3dp/cad/printed-6.11/insert-coupon-4p3.step
m3dp/cad/printed-6.11/insert-coupon-4p5.step
m3dp/cad/printed-6.11/insert-coupon-4p3.stl
m3dp/cad/printed-6.11/insert-coupon-4p4.stl
m3dp/cad/printed-6.11/insert-coupon-4p5.stl
m3dp/cad/printed-6.11/insert-coupon-4p7.stl
m3dp/cad/printed-6.11/insert-fit-coupon.FCStd
m3dp/cad/printed-6.11/p5-backplate-two-inserts-through-bolt-assembly.stl
m3dp/cad/printed-6.11/p5-backplate-two-inserts-through-bolt-print-flat.stl
m3dp/cad/printed-6.11/p5-backplate-two-inserts-through-bolt.step
m3dp/cad/printed-6.11/reference-only/superseded-30mm-dock/2020-rail-fit-coupon.FCStd
m3dp/cad/printed-6.11/reference-only/superseded-30mm-dock/2020-rail-fit-coupon.step
m3dp/cad/printed-6.11/reference-only/superseded-30mm-dock/2020-rail-fit-coupon.stl
m3dp/cad/printed-6.11/reference-only/superseded-30mm-dock/two-station-dock.FCStd
m3dp/cad/printed-6.11/reference-only/superseded-30mm-dock/two-station-dock.step
m3dp/cad/printed-6.11/unchanged-printables/4020-part-cooling-duct.stl
m3dp/cad/printed-6.11/unchanged-printables/hotend-holder.stl
m3dp/cad/printed-6.11/unchanged-printables/p2-spring-support-plate.stl
m3dp/cad/printed-6.11/unchanged-printables/p8-printed-bearing-arm.stl
m3dp/cad/printed-6.11/voron-integration/detector/tool-detector-mount.FCStd
m3dp/cad/printed-6.11/voron-integration/detector/tool-detector-mount.stl
m3dp/cad/printed-6.11/voron-integration/dock/2510-cage-fit-coupon.FCStd
m3dp/cad/printed-6.11/voron-integration/dock/build123d/2510-cage-fit-coupon-build123d-4p6.stl
m3dp/cad/printed-6.11/voron-integration/dock/fan-retainer-left.FCStd
m3dp/cad/printed-6.11/voron-integration/dock/fan-retainer-middle.FCStd
m3dp/cad/printed-6.11/voron-integration/dock/fan-retainer-right.FCStd
m3dp/cad/printed-6.11/voron-integration/dock/raised-2020-saddle-fit-coupon.FCStd
m3dp/cad/printed-6.11/voron-integration/dock/two-station-raised-rail-dock-prototype.FCStd
m3dp/cad/printed-6.11/voron-integration/rail/front-gantry-fit-coupon.FCStd
m3dp/cad/printed-6.11/voron-integration/rail/front-gantry-fit-coupon.stl
m3dp/cad/printed-6.11/voron-integration/rail/front-rail-support-left.FCStd
m3dp/cad/printed-6.11/voron-integration/rail/front-rail-support-left.stl
m3dp/cad/printed-6.11/voron-integration/rail/front-rail-support-right.FCStd
m3dp/cad/printed-6.11/voron-integration/rail/front-rail-support-right.stl
m3dp/cad/printed-6.11/voron-integration/tap/chaoticlab-v2-interface-fit-gauge.stl
stl/p5-backplate-two-inserts-through-bolt-print-flat.stl
stl/reference-only/old-2020-rail-fit-coupon.stl
