minimal3dp/m3dp-changer/output/pdf/CxChanger-B1-illustrated-assembly-guide.pdf

M3DP CHANGER / B1 BENCH ASSEMBLY

# See the finished arrangement

Eight printed pieces: one mechanism, one detector mount and two removable hotend holders.

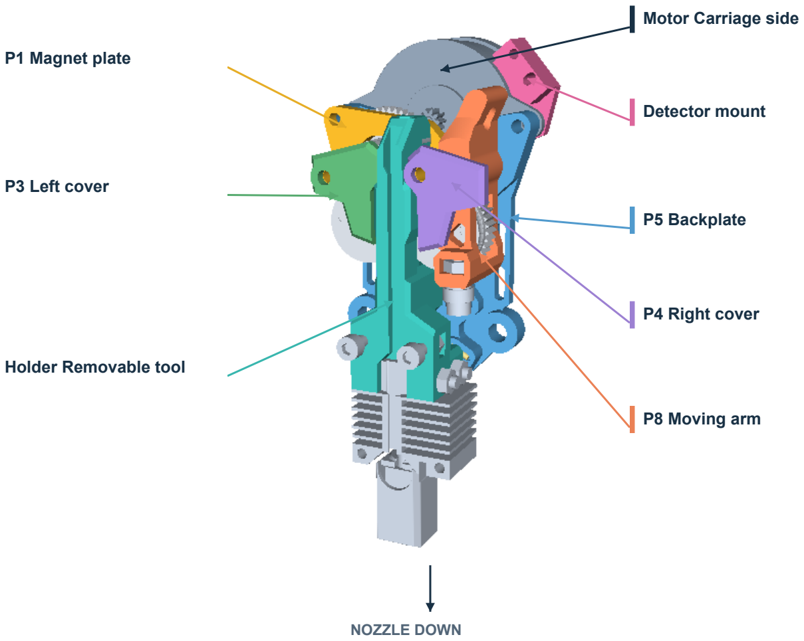
[picture p48: figure]
P1 Magnet plate; P3 Left cover; Holder Removable tool; Motor Carriage side; Detector mount; P5 Backplate; P4 Right cover; P8 Moving arm; NOZZLE DOWN

Corrected 6.11 + integral pillars | 4.6 mm insert bores | 01 Nov 2026 | 01

Start here

Lay out the seven part types on page 2. Build the head first, then make the two hotend modules. Only one module attaches to the head at a time.

Reading the pictures

Colors identify parts; your prints can all be black. The motor is behind the mechanism on the carriage side. The long teal holder is on the coupling side. Views are assembly orientations, not print orientations.

# Match each print to its name

Keep these four adapted plates together: P1, P3, P4 and P5.

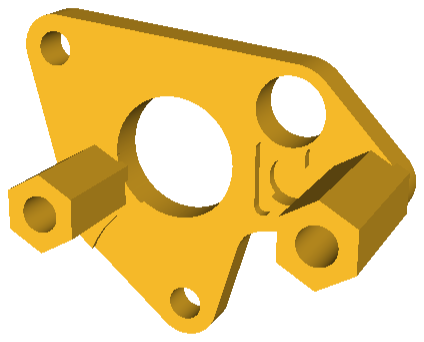
[picture p49: figure]
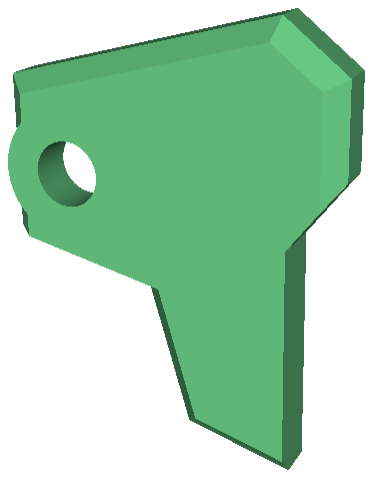
[picture p50: figure]
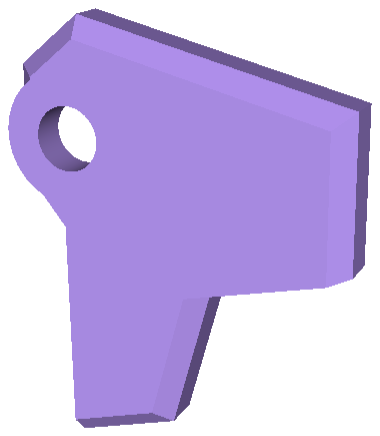
[picture p51: figure]
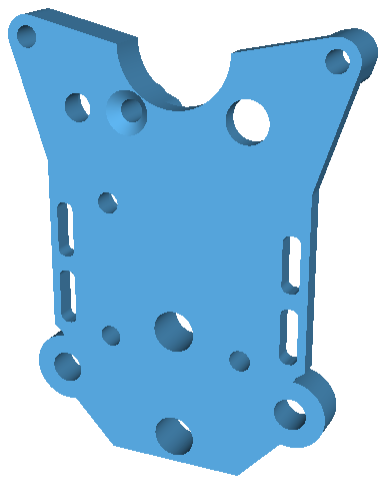
[picture p52: figure]
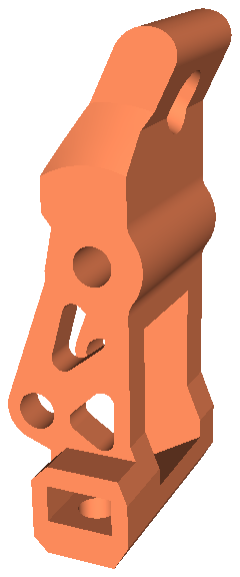
[picture p53: figure]
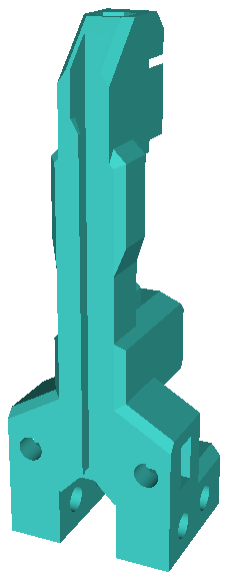
[picture p54: figure]
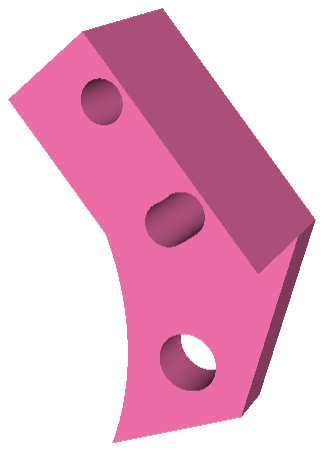
[picture p55: figure]

Corrected 6.11 + integral pillars | 4.6 mm insert bores | 01 Nov 2026 | 02

P1 / 1x

Magnet plate

Two integral pillars; one piece.

P3 / 1x

Left cover

Smaller cover; reinforced bolt seat.

P4 / 1x

Right cover

Matching right cover; bolt seat.

P5 / 1x

Backplate

Two insert seats near the lower end.

P8 / 1x

Printed arm

One-piece moving arm with roller fork.

Holder / 2x

Hotend holder

Make one module for T0 and one for T1.

Detector / 1x

Detector mount

Small bracket with pivot hole and arc slot.

Use the printed arm

P8 replaces the CNC-arm alternative. Do not add P2, P6 or P7, or duplicate their roller hardware.

These are assembly parts

Keep these B1 prints. The earlier fan, saddle and insert coupons were fit tests. This guide starts from the finished B1 parts.

Exact STL filenames are listed in the companion assembly-guide/README.md.

# Understand the layers

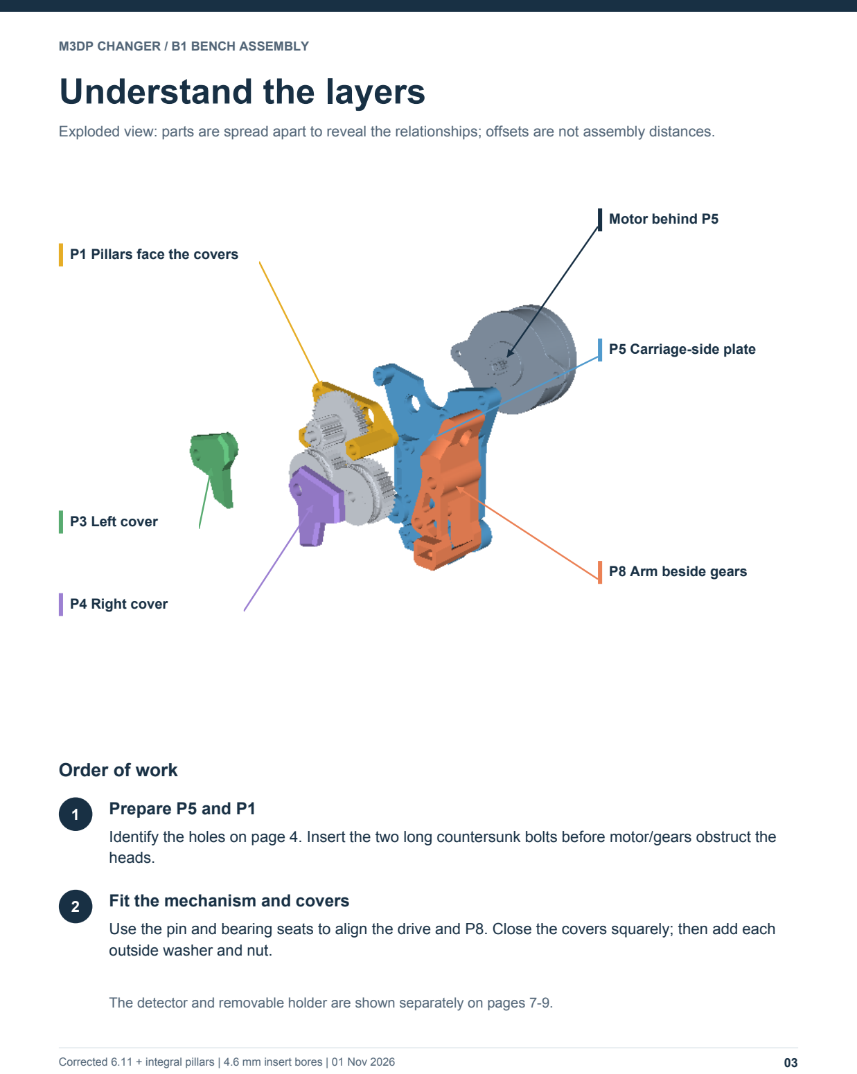
[picture p56: page 3]

Exploded view: parts are spread apart to reveal the relationships; offsets are not assembly distances.

Corrected 6.11 + integral pillars | 4.6 mm insert bores | 01 Nov 2026 | 03

P3 Left cover

P4 Right cover

P1 Pillars face the covers

Motor behind P5

P5 Carriage-side plate

P8 Arm beside gears

### Order of work

1

Prepare P5 and P1

Identify the holes on page 4. Insert the two long countersunk bolts before motor/gears obstruct the heads.

2

Fit the mechanism and covers

Use the pin and bearing seats to align the drive and P8. Close the covers squarely; then add each outside washer and nut.

The detector and removable holder are shown separately on pages 7-9.

# Identify the backplate holes

Look at the broad carriage-side face of P5. This view is from behind the assembled head.

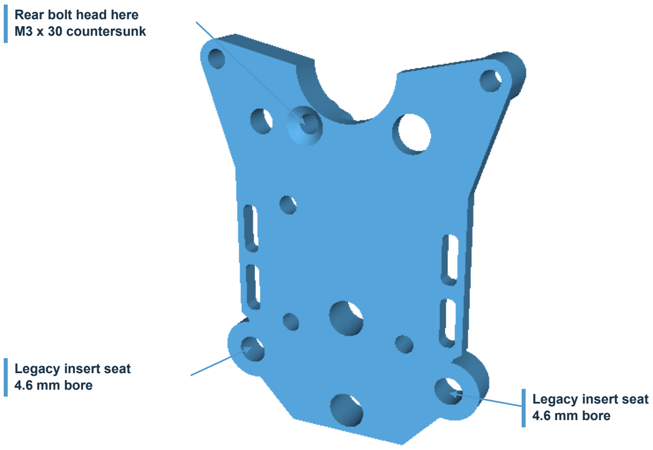
[picture p57: figure]
Rear bolt head here M3 x 30 countersunk; Legacy insert seat 4.6 mm bore

Corrected 6.11 + integral pillars | 4.6 mm insert bores | 01 Nov 2026 | 04

1

Leave these two seats unused for B1

These 4.6 mm bores were prepared for M3 inserts at the original blower interface. The current top blower is relocated. These holes do not fasten the B1 plates or the TAP adapter.

2

Pre-fit the rear through-bolt

The upper countersink takes the M3 x 30 bolt. It passes through the rear stack to P4. The rear hole is a clearance joint, not an insert seat.

P1 pillar bores also take through-bolts. Do not install heat-set inserts in P1.

# Fit the drive and moving arm

Covers and hotend holder removed for visibility. Keep the spring mechanism in its original arrangement.

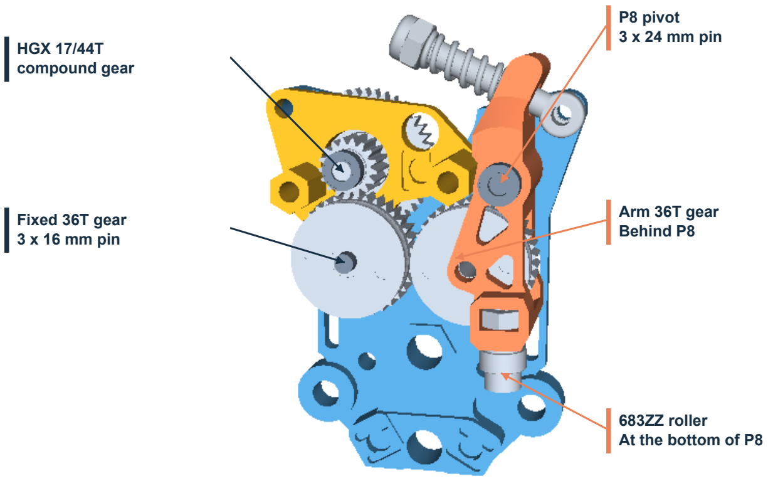
[picture p58: figure]
HGX 17/44T compound gear; Fixed 36T gear 3 x 16 mm pin; P8 pivot 3 x 24 mm pin; Arm 36T gear Behind P8; 683ZZ roller At the bottom of P8

Corrected 6.11 + integral pillars | 4.6 mm insert bores | 01 Nov 2026 | 05

P8 roller hardware order

M3 x 8 head → 683ZZ bearing → 3.2 x 6 x 0.5 washer → P8 → M3 nut

MR63ZZ bearings (3 x 6 x 2.5 mm): two support the compound-gear axis in P5 and P3; the third sits in P4 at the P8 pivot. The other P3 opening receives the fixed-gear pin. These are not extra screw holes. Fit them before the covers; recheck free roller rotation, full gear turns and arm stroke.

One shaft placement still needs a bench check

The saved source leaves the second 3 x 16 mm pin at the unused CNC arm. It is not shown installed at the P8 gear. Confirm the P8 gear shaft seating and retention before treating the head as assembled; do not copy the floating CNC pin position.

# Close the two pillar joints

Schematic stacks below show hardware order; the CAD view identifies the two pillars on P1.

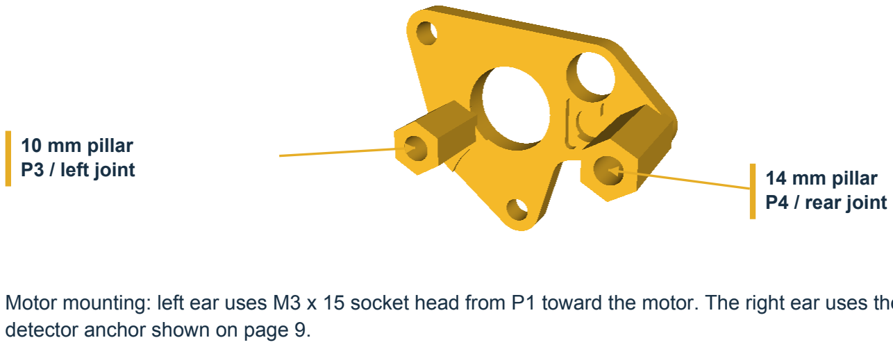
[picture p59: figure]
P3 / left joint; 14 mm pillar; P4 / rear joint; detector anchor shown on page 9.

Corrected 6.11 + integral pillars | 4.6 mm insert bores | 01 Nov 2026 | 06

### 10 mm pillar

Motor mounting: left ear uses M3 x 15 socket head from P1 toward the motor. The right ear uses the M3 x 22

A Left joint - M3 x 20 countersunk

Seat the head in P1. The washer and nut sit outside the green cover.

B Rear joint - M3 x 30 countersunk

The bolt starts at P5, continues through the P1 pillar, then exits the purple cover.

Use the checked hardware sizes

90-degree countersunk heads: actual diameter no larger than 5.6 mm. Washers: 3.2 mm ID, 7 mm maximum OD, 0.5 mm thick. Nuts: 5.5 mm across flats, 2.4 mm thick. Both heads must remain recessed.

Snug the joints only after everything seats squarely. Recheck free gear and arm movement.

# Build two hotend modules

One teal holder per tool. Label the finished modules T0 and T1.

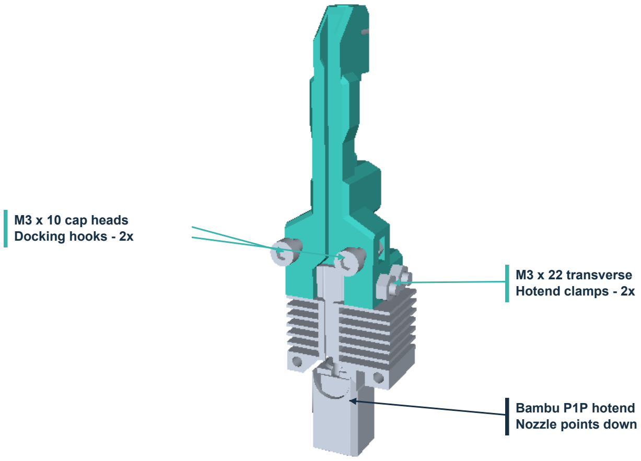
[picture p60: figure]
M3 x 10 cap heads Docking hooks - 2x; M3 x 22 transverse Hotend clamps - 2x; Bambu P1P hotend Nozzle points down

Corrected 6.11 + integral pillars | 4.6 mm insert bores | 01 Nov 2026 | 07

1

Seat the hotend in the holder

Fit the hotend into the lower pocket and align the transverse clamp holes. Use two M3 x 22 socket-head screws and the matching nut pockets.

2

Fit the separate docking hooks

Use two magnetic-head M3 x 10 socket-head screws at the hook locations, 15 mm apart. These are not the long transverse clamp screws. Each module uses four M3 nuts in total.

Check actual hook heads attract the dock magnet. Ordinary stainless heads may not.

# Connect the magnetic coupling

Holder mating face shown at left; the right view shows the module separated from the head.

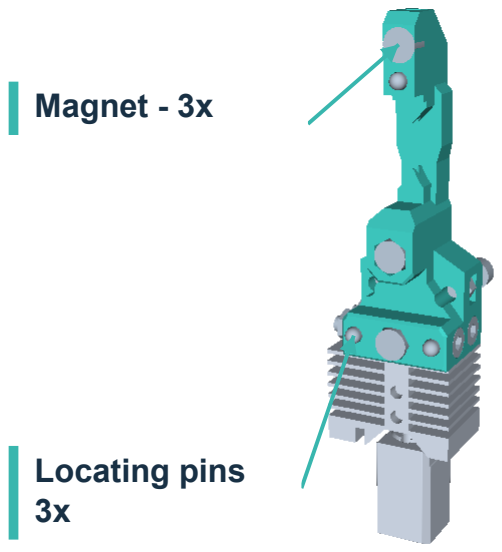
[picture p61: figure]
Magnet - 3x; Locating pins 3x
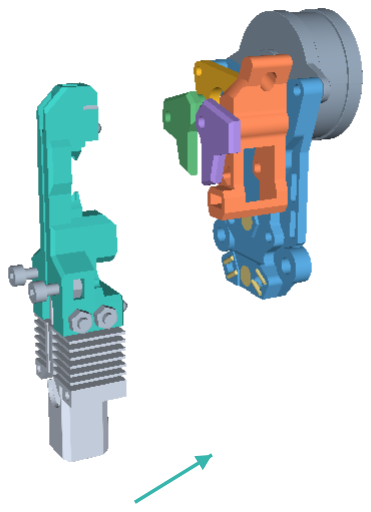
[picture p62: figure]

Corrected 6.11 + integral pillars | 4.6 mm insert bores | 01 Nov 2026 | 08

Mate the teal holder to the coupling face of the head.

1

Fit the coupling hardware

Each holder takes three N52 6 x 4 mm magnets and three round-head 3 x 4 mm locating pins. The head takes three opposing magnets and six 1.5 x 5 mm cylindrical pins, arranged as three locating grooves.

### 2 Check polarity before fixing magnets

Bring the module toward the head as shown. Every opposing magnet pair must attract. Check the polarity of each pair before securing the magnets in their pockets.

### 3 Check what actually touches

The three round-head pins seat against the three cylindrical-pin grooves. The opposing magnets must retain a small gap; magnet-to-magnet contact must not prevent the locating pins from seating.

Fit one module at a time

Seat and remove T0, then repeat with T1. Check for rocking, snagging or contact with the P4 washer/nut. A good fit on one module does not confirm the other.

# Install the detector bracket

Rear view: the pink bracket sits directly on the motor mounting ear. No spacer belongs underneath.

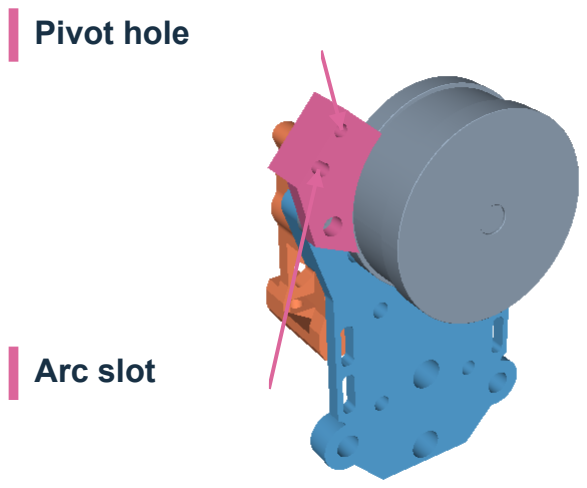
[picture p63: figure]
Pivot hole; Arc slot
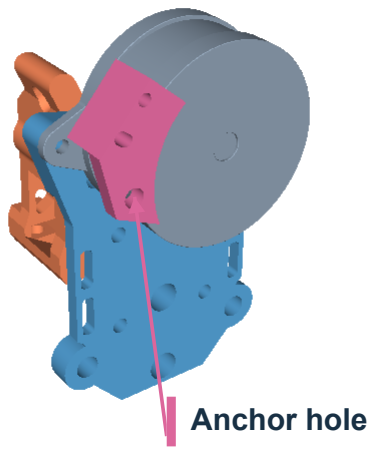
[picture p64: figure]
Anchor hole

Corrected 6.11 + integral pillars | 4.6 mm insert bores | 01 Nov 2026 | 09

SEATED POSITION
LIFTED TO SHOW CONTACT

### 1 Use the longer anchor screw

Replace the source M3 x 16 button-head anchor with M3 x 22. Keep the existing M3 nut below P5; add a second M3 nut above the detector. The mount sits directly against the motor ear.

### 2 Attach the D2F-01F switch

Use two M2 x 18 socket-head screws, two M2 nuts and four M2 washers (5 mm OD, 0.4 mm thick). Use one washer on each side of each joint. One hole is the pivot; the arc slot allows angular adjustment.

### 3 Aim the plunger toward the P8 actuator

The switch is omitted from these CAD views. Adjust its angle by moving P8 by hand, then secure it without bottoming the plunger. The mount geometry alone does not establish correct actuation.

Required switch response

Empty head: not detected. Tool without filament: not detected. Tool with filament: detected. Repeat all three conditions before relying on automatic tool changes.

# Check the assembled mechanism

This is the next bench step after printing. Keep the parts for the final build once these checks pass.

Corrected 6.11 + integral pillars | 4.6 mm insert bores | 01 Nov 2026 | 10

All plates seat squarely

P1, P3, P4 and P5 meet their supports without bending or rocking. There are no added metal standoffs at the integral pillars.

Both through-bolts seat and clear

Heads remain recessed. Washers sit flat; nuts engage. The P4 washer/nut clears the hotend holder throughout attachment and removal.

Drive and P8 move freely

Gears turn through complete revolutions. P8 moves through its full release/clamp stroke. The 683ZZ roller turns freely; pins remain seated.

Both modules locate repeatably

T0 and T1 each seat on all three locating grooves. Magnet polarity is correct, magnets retain a gap, and the module does not rock.

Detector repeats its truth table

Verify the three physical conditions on page 9. Adjust by hand before trusting the signal.

Record the remaining shaft check

Confirm the P8 gear shaft installation and retention. Its second 3 x 16 mm pin was not saved in the printed-arm position in the source assembly.

After this bench fit

Continue with the TAP/top-blower and dock integration instructions. Those parts, wiring, heating and automatic motion are outside this B1 guide. Report which checks pass and any part or hole that does not line up.

Source and validation | CAD-derived orientation, not a completed physical assembly test. See source-audit.md for geometry selection and the known shaft omission.
