minimal3dp/m3dp-changer/m3dp/cad/printed-6.11/reference-only/superseded-30mm-dock/README.md

# Superseded 30 mm dock — reference only

The saved files and reports describe the earlier low-rail geometry. Subsequent full-head checks found a neighboring-tool interference at the 30 mm station pitch and enclosure/bed conflicts with the low-rail layout. Use the raised 34/38 mm dock in `../../voron-integration/dock/` and the active `stl/` print list. Historical reports do not validate the new design.

The historical generator originally expected `source/dock-6.11-EN.STEP` beside it; the unmodified source remains in `../../source/`.
