minimal3dp/m3dp-changer/m3dp/cad/printed-6.11/assembly-guide/images/guide-preview.png

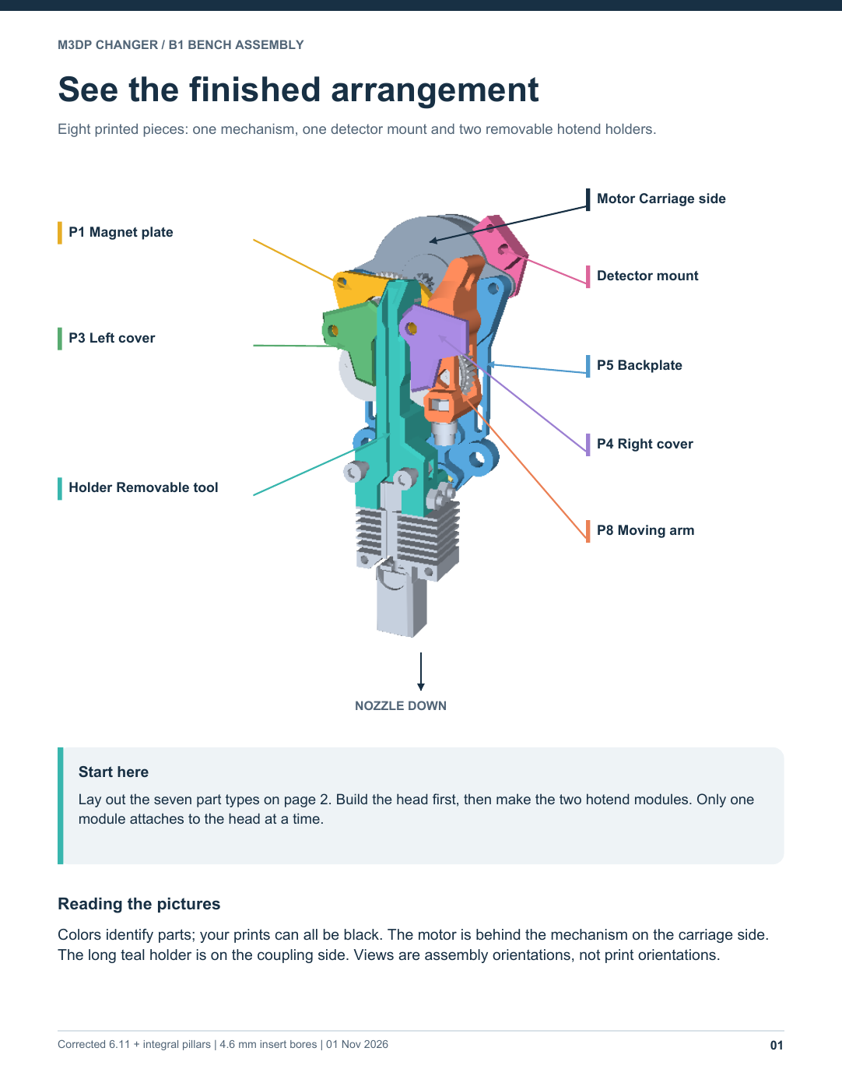
m3dp/cad/printed-6.11/assembly-guide/images/guide-preview.png
