minimal3dp/m3dp-changer/m3dp/cad/printed-6.11/assembly-guide/images/part-detector.png

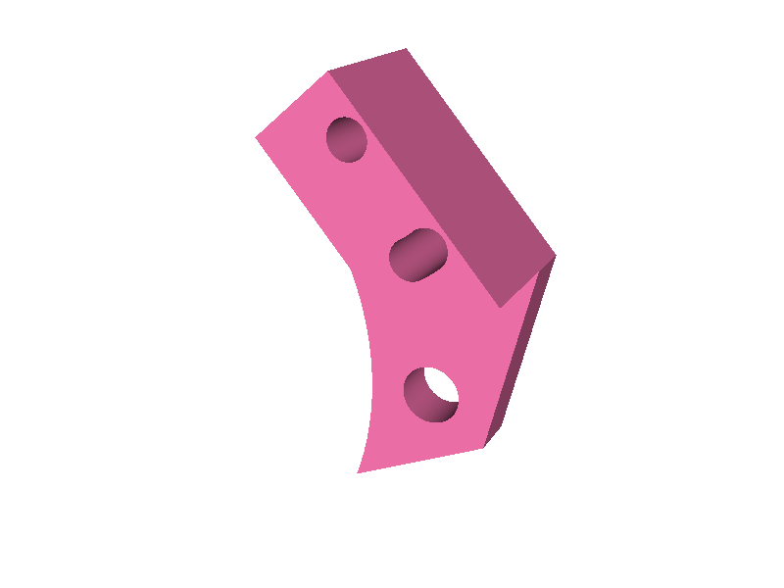
m3dp/cad/printed-6.11/assembly-guide/images/part-detector.png
