minimal3dp/m3dp-changer/m3dp/cad/printed-6.11/assembly-guide/images/part-p3.png

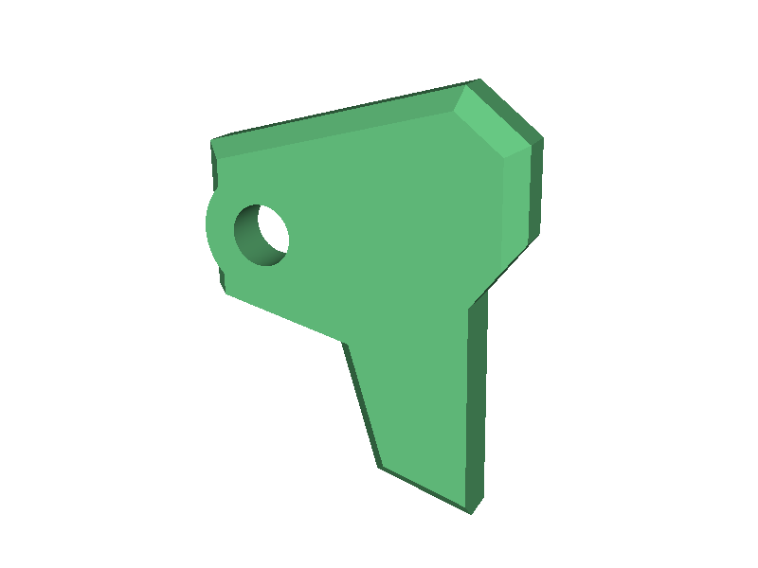
m3dp/cad/printed-6.11/assembly-guide/images/part-p3.png
