minimal3dp/m3dp-changer/m3dp/cad/printed-6.11/assembly-guide/images/part-p8.png

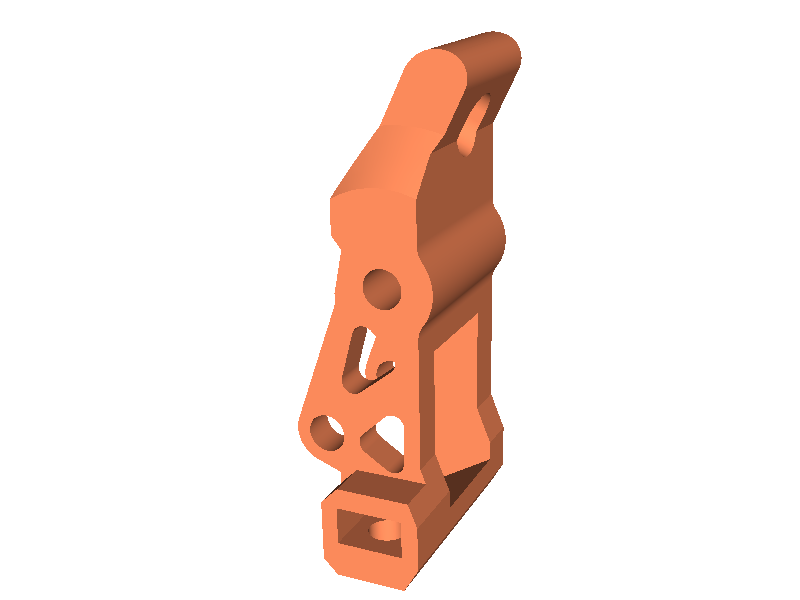
m3dp/cad/printed-6.11/assembly-guide/images/part-p8.png
