minimal3dp/m3dp-changer/m3dp/cad/printed-6.11/insert-fit-coupon-preview.png

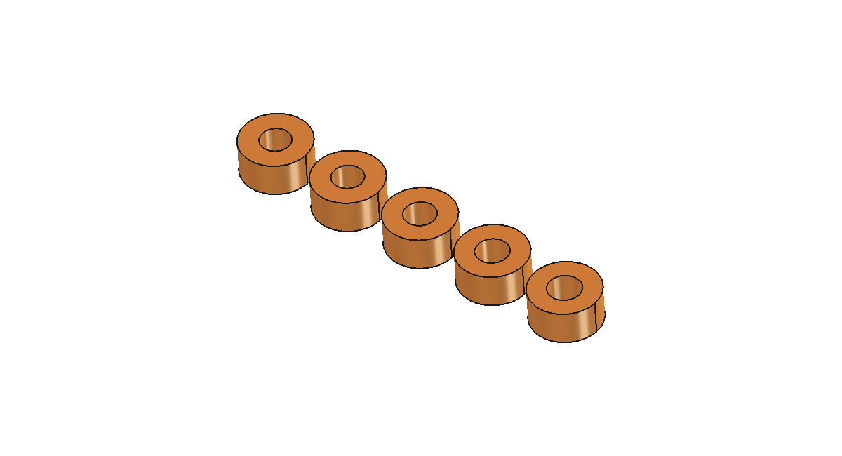
m3dp/cad/printed-6.11/insert-fit-coupon-preview.png
