minimal3dp/m3dp-changer/m3dp/cad/printed-6.11/p1-magnet-plate-integral-pillars-preview.png

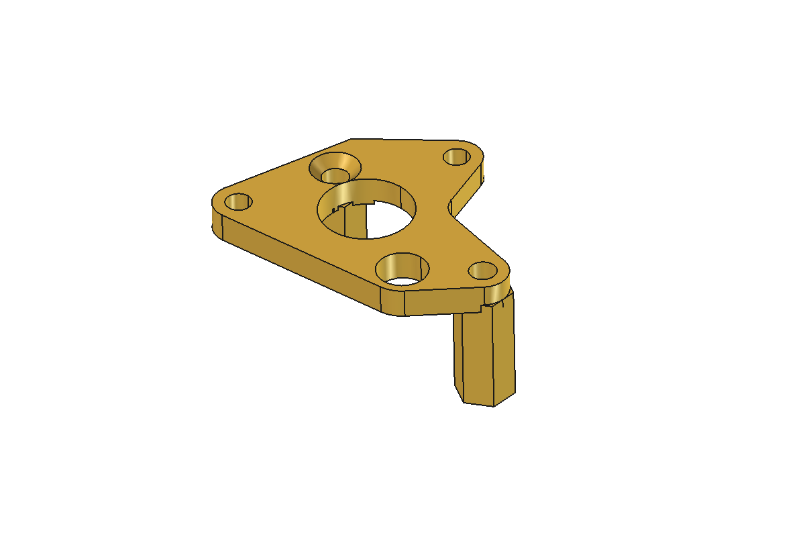
m3dp/cad/printed-6.11/p1-magnet-plate-integral-pillars-preview.png
