minimal3dp/m3dp-changer/m3dp/cad/printed-6.11/p3-cover-left-clamp-web-preview.png

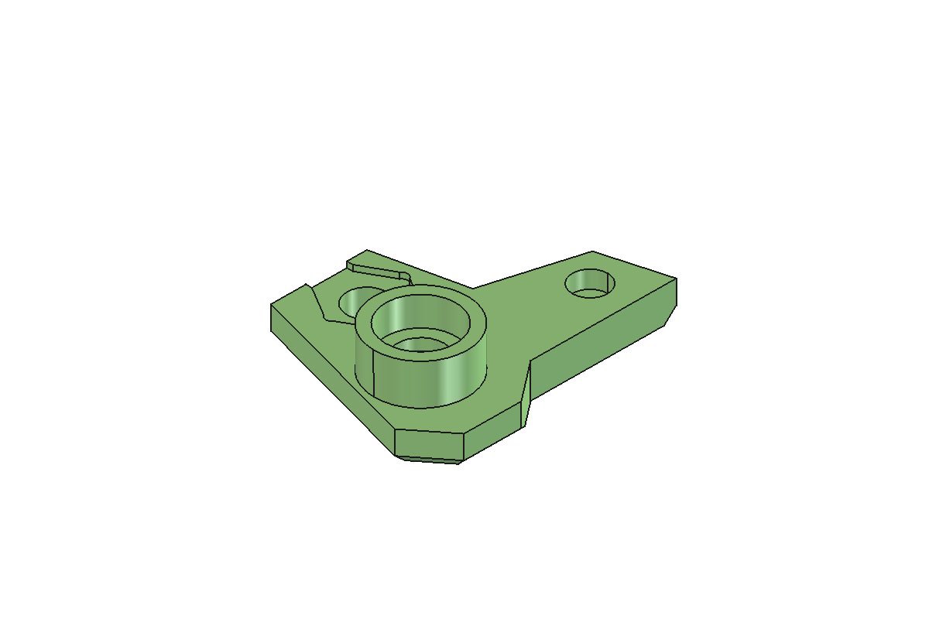
m3dp/cad/printed-6.11/p3-cover-left-clamp-web-preview.png
