minimal3dp/m3dp-changer/m3dp/cad/printed-6.11/p4-cover-right-clamp-web-preview.png

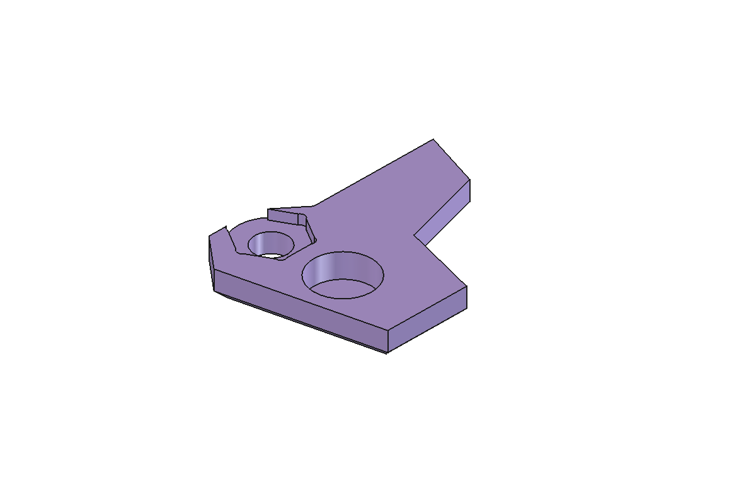
m3dp/cad/printed-6.11/p4-cover-right-clamp-web-preview.png
