minimal3dp/m3dp-changer/m3dp/cad/printed-6.11/p5-backplate-two-inserts-through-bolt-preview.png

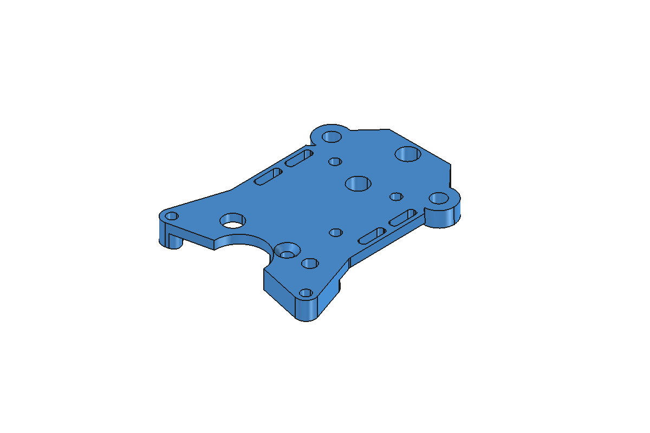
m3dp/cad/printed-6.11/p5-backplate-two-inserts-through-bolt-preview.png
