minimal3dp/m3dp-changer/m3dp/cad/printed-6.11/voron-integration/detector/tool-detector-mount-preview.png

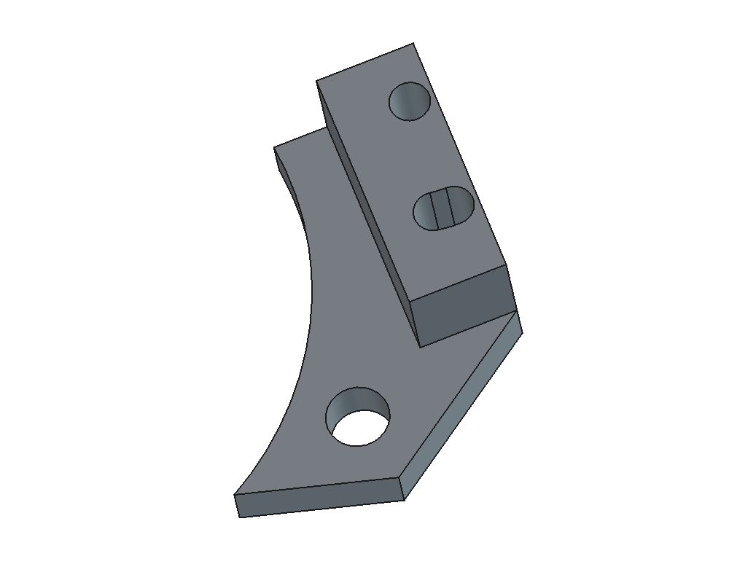
m3dp/cad/printed-6.11/voron-integration/detector/tool-detector-mount-preview.png
