minimal3dp/m3dp-changer/m3dp/cad/printed-6.11/voron-integration/dock/2510-cage-fit-coupon-preview.png

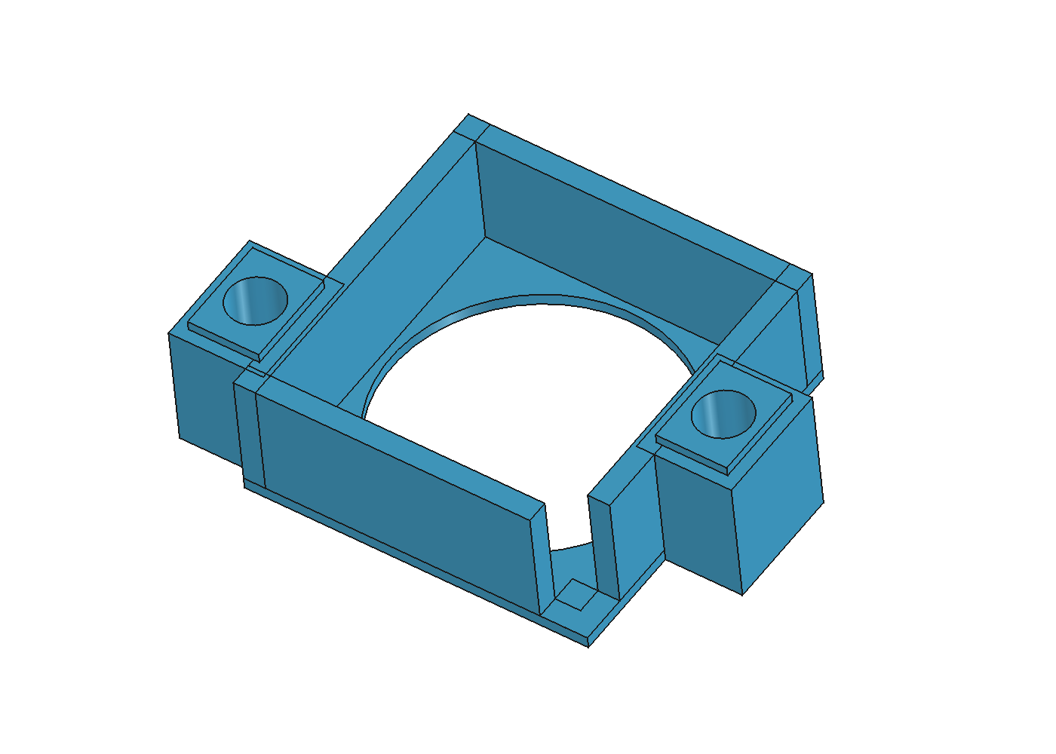
m3dp/cad/printed-6.11/voron-integration/dock/2510-cage-fit-coupon-preview.png
