minimal3dp/m3dp-changer/m3dp/cad/printed-6.11/voron-integration/dock/build123d/2510-cage-fit-coupon-build123d-4p6.png

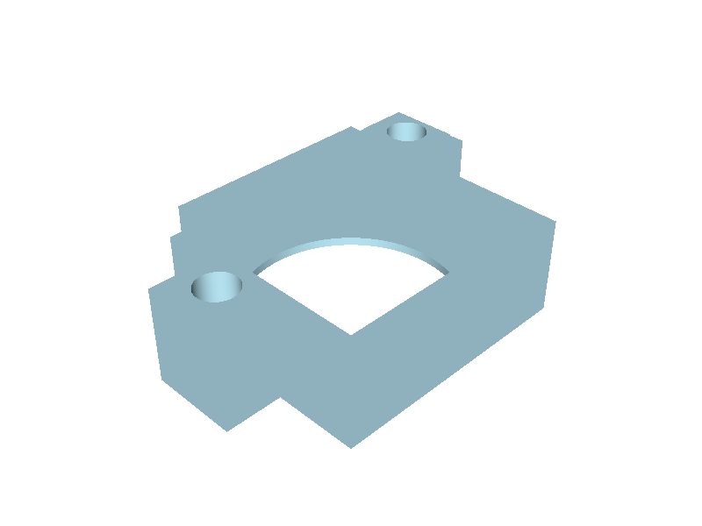
m3dp/cad/printed-6.11/voron-integration/dock/build123d/2510-cage-fit-coupon-build123d-4p6.png
