minimal3dp/m3dp-changer/m3dp/cad/printed-6.11/voron-integration/dock/build123d/cage-retainers-installed-angled.png

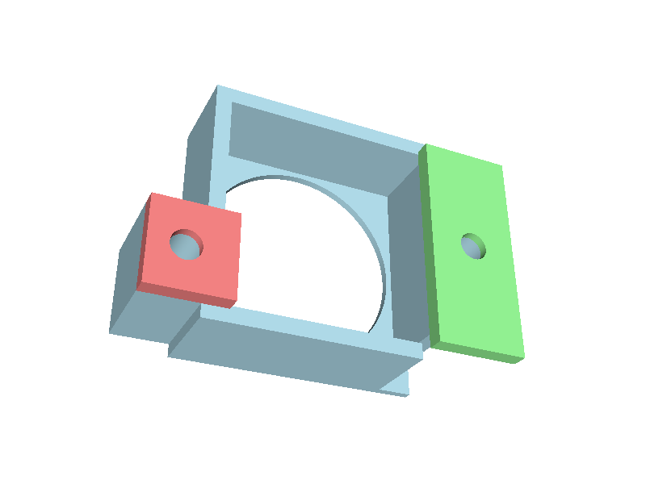
m3dp/cad/printed-6.11/voron-integration/dock/build123d/cage-retainers-installed-angled.png
