minimal3dp/m3dp-changer/m3dp/cad/printed-6.11/voron-integration/dock/fan-retainer-left-preview.png

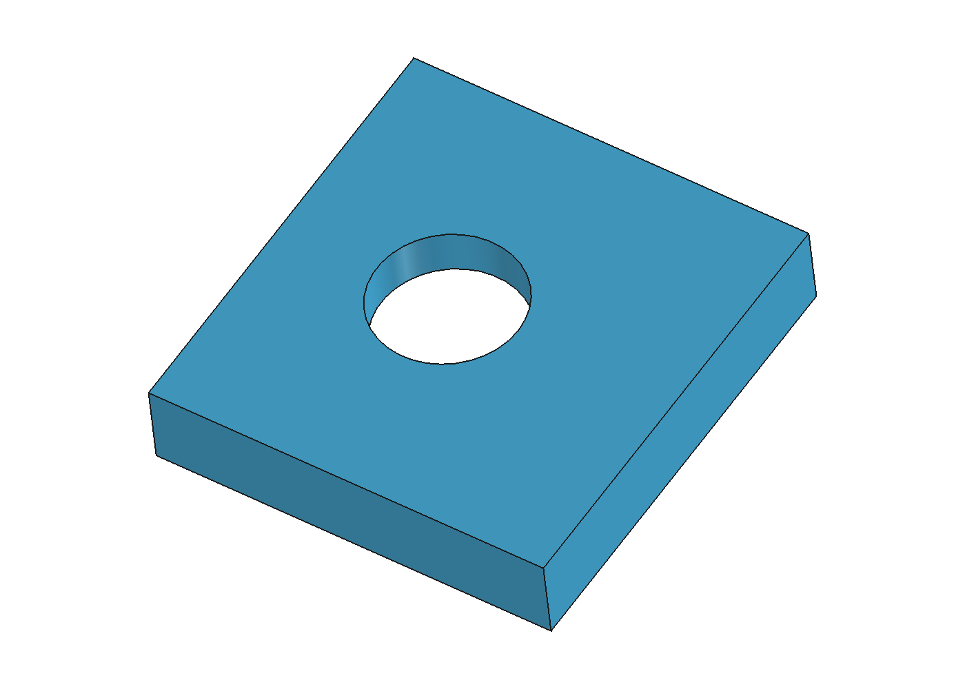
m3dp/cad/printed-6.11/voron-integration/dock/fan-retainer-left-preview.png
