minimal3dp/m3dp-changer/m3dp/cad/printed-6.11/voron-integration/dock/raised-2020-saddle-fit-coupon-preview.png

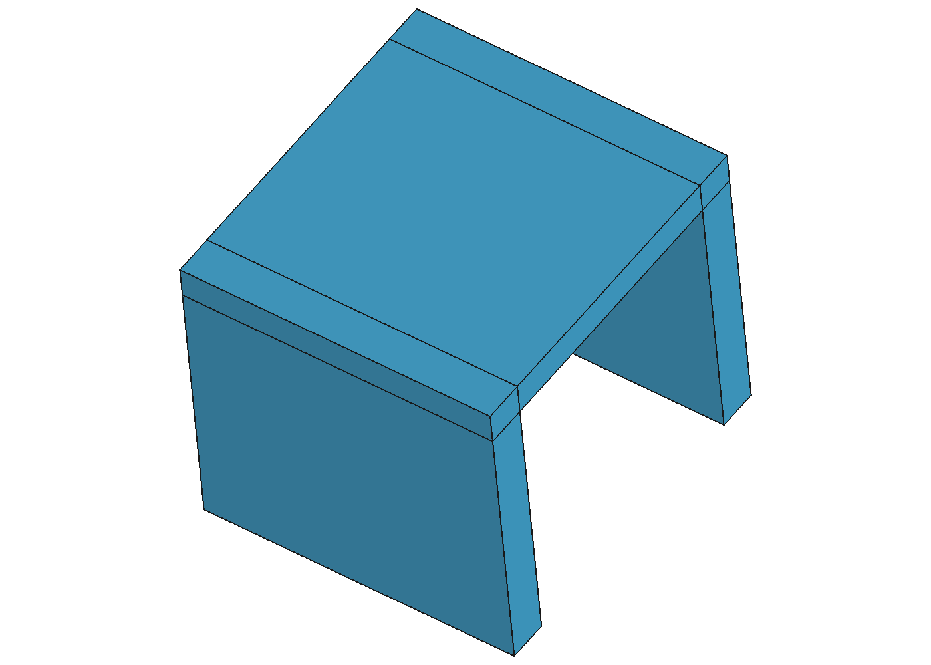
m3dp/cad/printed-6.11/voron-integration/dock/raised-2020-saddle-fit-coupon-preview.png
