minimal3dp/m3dp-changer/m3dp/cad/printed-6.11/voron-integration/dock/raised-dock-layout.png

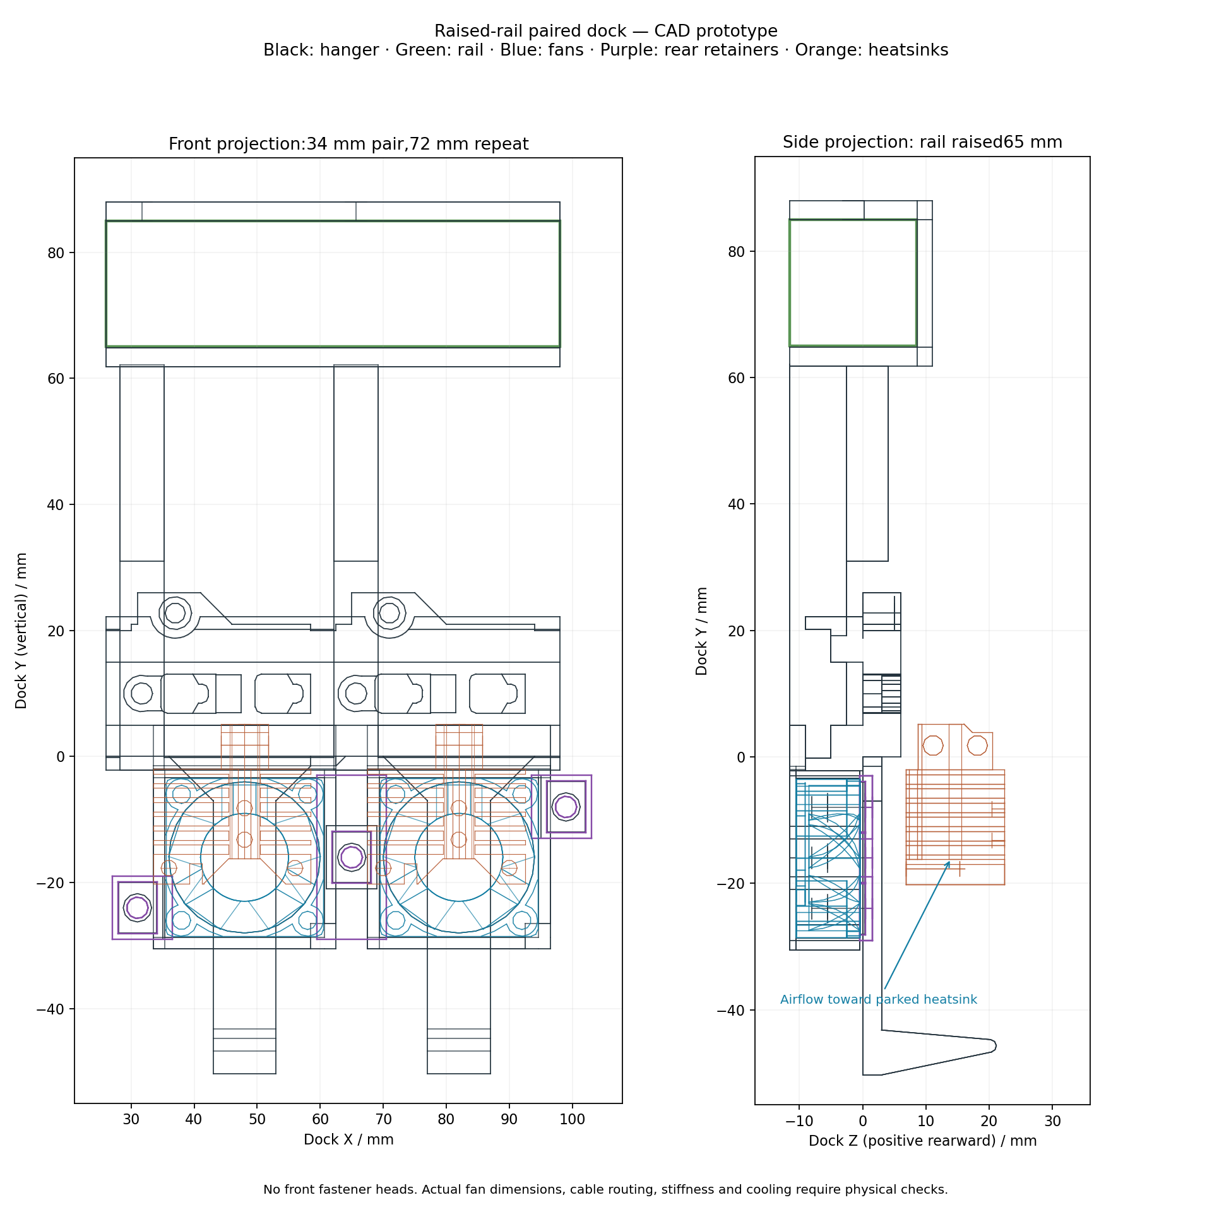
m3dp/cad/printed-6.11/voron-integration/dock/raised-dock-layout.png
