minimal3dp/m3dp-changer/m3dp/cad/printed-6.11/voron-integration/dock/two-station-raised-rail-dock-prototype-preview.png

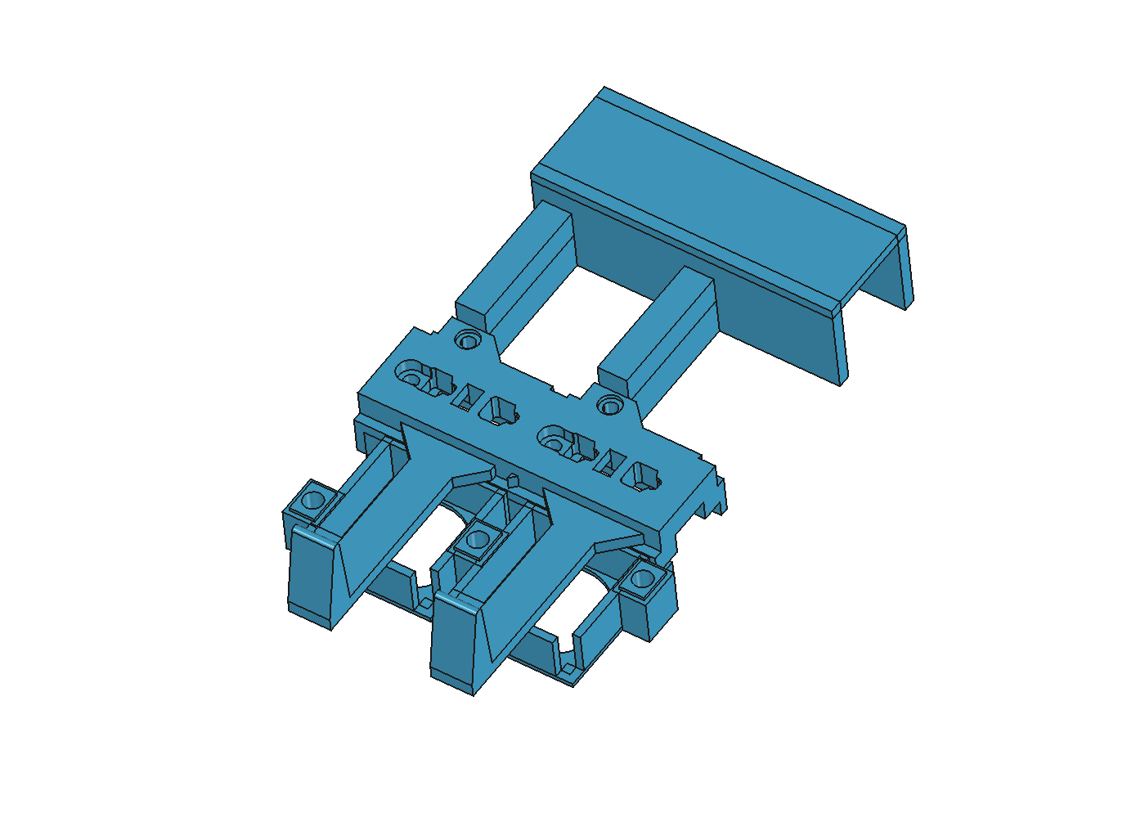
m3dp/cad/printed-6.11/voron-integration/dock/two-station-raised-rail-dock-prototype-preview.png
