minimal3dp/m3dp-changer/m3dp/cad/printed-6.11/voron-integration/rail/front-gantry-fit-coupon-preview.png

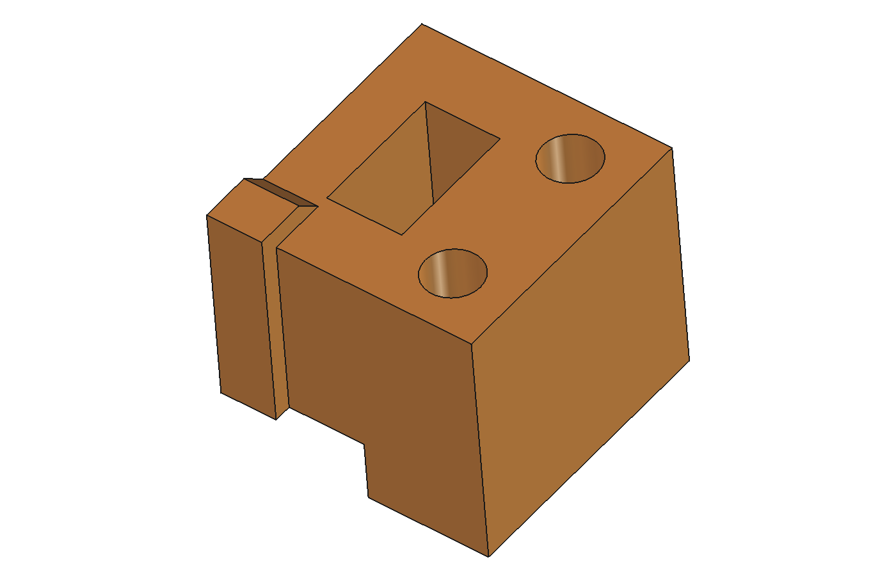
m3dp/cad/printed-6.11/voron-integration/rail/front-gantry-fit-coupon-preview.png
