minimal3dp/m3dp-changer/m3dp/cad/printed-6.11/voron-integration/rail/front-rail-support-left-preview.png

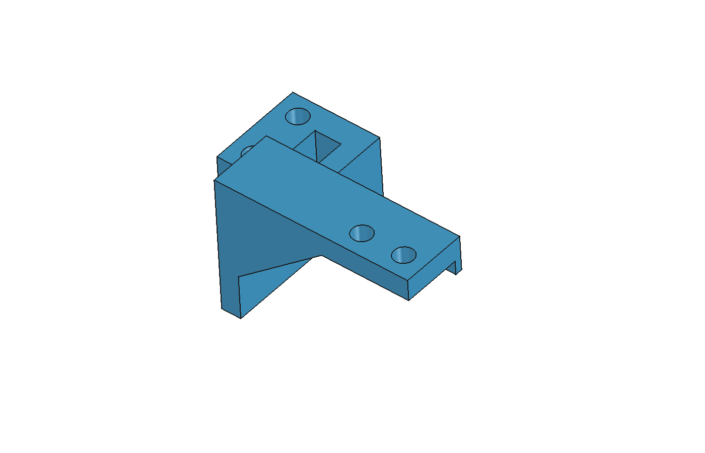
m3dp/cad/printed-6.11/voron-integration/rail/front-rail-support-left-preview.png
