minimal3dp/m3dp-changer/m3dp/cad/printed-6.11/voron-integration/tap/tap-fit-gauge-preview.png

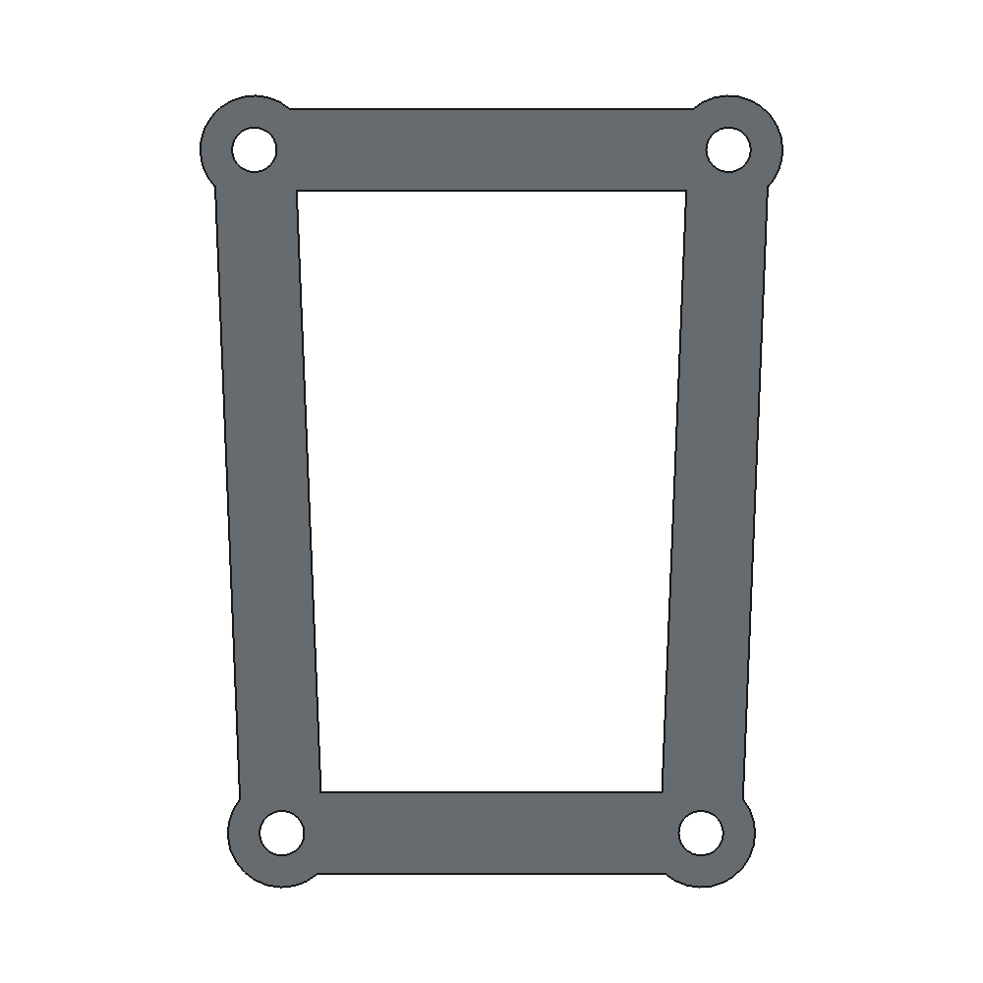
m3dp/cad/printed-6.11/voron-integration/tap/tap-fit-gauge-preview.png
