minimal3dp/m3dp-changer/m3dp/klipper/nevermore.cfg

# Local copy of ../voron/nevermore.cfg for six-heater routing and KNOMI.
############### Config options ##################

[gcode_macro _BEDFANVARS]
variable_threshold: 55		# If bed temp target is above this threshold, fans will be enabled. If temp is set to below this threshold, fans will be disabled.
variable_fast: 0.9		# Fan speed once bed temp is reached  
variable_slow: 0.2		# Fan speed while bed is heating
gcode:

########## Bed Fans #########

[fan_generic BedFans]
pin: PE5
#cycle_time: 0.05
kick_start_time: 0.5

########## Aliases #########

[gcode_macro BEDFANSSLOW]
gcode:
	# Vars
	{% set SLOW = printer["gcode_macro _BEDFANVARS"].slow|float %}
	
	SET_FAN_SPEED FAN=BedFans SPEED={SLOW}

[gcode_macro BEDFANSFAST]
gcode:
	# Vars
	{% set FAST = printer["gcode_macro _BEDFANVARS"].fast|float %}
	
	SET_FAN_SPEED FAN=BedFans SPEED={FAST}

[gcode_macro BEDFANSOFF]
gcode:
	SET_FAN_SPEED FAN=BedFans SPEED=0

############ Command overrides ############

# Override, set fan speeds to low and start monitoring loop.
[gcode_macro SET_HEATER_TEMPERATURE]
rename_existing: _SET_HEATER_TEMPERATURE
gcode:
    # Let Klipper validate and route the exact named heater, including extruder1..5.
    # An implicit M104 would incorrectly select the currently active tool.
    _SET_HEATER_TEMPERATURE {rawparams}
    {% if params.HEATER|default("") == "heater_bed" %}
        {% set target = params.TARGET|default(0)|float %}
        {% set threshold = printer["gcode_macro _BEDFANVARS"].threshold|float %}
        {% if target >= threshold %}
            BEDFANSSLOW
            UPDATE_DELAYED_GCODE ID=bedfanloop DURATION=1
        {% else %}
            BEDFANSOFF
            UPDATE_DELAYED_GCODE ID=bedfanloop DURATION=0
        {% endif %}
    {% endif %}

# Preserve native M190 wait semantics and KNOMI status, with bed-fan control.
[gcode_macro M190]
rename_existing: M99190
gcode:
    {% set target = params.S|default(0)|float %}
    {% if "gcode_macro _KNOMI_STATUS" in printer %}
        SET_GCODE_VARIABLE MACRO=_KNOMI_STATUS VARIABLE=heating_bed VALUE=True
    {% endif %}
    M140 S{target}
    M99190 {rawparams}
    {% if target >= printer["gcode_macro _BEDFANVARS"].threshold|float %}
        BEDFANSFAST
    {% endif %}
    {% if "gcode_macro _KNOMI_STATUS" in printer %}
        SET_GCODE_VARIABLE MACRO=_KNOMI_STATUS VARIABLE=heating_bed VALUE=False
    {% endif %}

# Replace M140 (Set Bed Temperature) to just be an alias of SET_HEATER_TEMPERATURE (which has associated bed fan logic if enabled)
[gcode_macro M140]
rename_existing: M99140
gcode:
	# Parameters
	{% set S = params.S|default(0)|float %}
	
	SET_HEATER_TEMPERATURE HEATER=heater_bed TARGET={S}
	
# Replace TURN_OFF_HEATERS
[gcode_macro TURN_OFF_HEATERS]
rename_existing: _TURN_OFF_HEATERS
gcode:
	BEDFANSOFF
	UPDATE_DELAYED_GCODE ID=bedfanloop DURATION=0
	_TURN_OFF_HEATERS
	
################ Monitoring loop #####################

# Turns bed fans to "fast" speed once target bed temp is reached.
[delayed_gcode bedfanloop]
gcode:
	# Vars
	{% set THRESHOLD = printer["gcode_macro _BEDFANVARS"].threshold|int %}
	
	{% if printer.heater_bed.target >= THRESHOLD %}								# Continue only if target temp greater than threshold.
		{% if printer.heater_bed.temperature|int >= (printer.heater_bed.target|int - 1) %}
			BEDFANSFAST															# If within 1 degree of target temp: Higher speed fans
		{% else %}
			UPDATE_DELAYED_GCODE ID=bedfanloop DURATION=5						# If temp not reached yet: loop again
		{% endif %}
	{% endif %}
